ohmydigifab/OpenBLW/README.md

# OpenBLW
Open Biwa Lake Walker

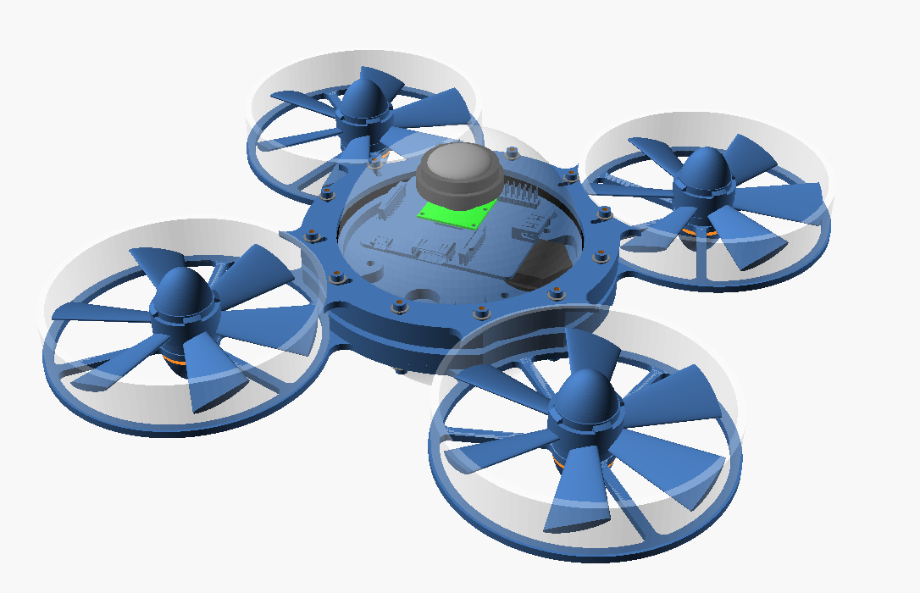
[picture p1: resources/OpenBLW.png]
OpenBLW
