ohmydigifab/OpenBLW/pcb/interface_board/interface_board-BOM.xls

Qty | Value | Part No. | Device | Package | Parts | Description | CATEGORY | CURRENT-MAX | CURRENT-TRIP | DESCRIPTION | DOCUMENTATION_LINK | DOCUMENTATION_URL | FAMILY | MANUFACTURER | MPN | OC_FARNELL | OC_NEWARK | PACKAGE | PART_NUMBER | R_MINMAX | SERIES | SUPPLIER | SUPPLIER_ITEM_LINK | SUPPLIER_ITEM_NUMBER | SUPPLIER_ITEM_URL | SUPPLIER_LINK | SUPPLIER_NAME | SUPPLIER_URL | TIME_TO_TRIP | VOLTAGE-MAX
2 | 0R | ERJ-2GE0R00X | R-EU_R0402 | R0402 | R2, R3 | RESISTOR, European symbol
3 | 0R | ERJ-6GEY0R00V | R-EU_R0805 | R0805 | R7, R8, R9 | RESISTOR, European symbol
4 | 1.8K | ERJ-2GEJ182X | R-EU_R0402 | R0402 | R13, R14, R16, R17 | RESISTOR, European symbol
1 | 10R | ERJ-3EKF10R0V | R-EU_R0603 | R0603 | R27 | RESISTOR, European symbol
3 | 100K | ERJ-2GEJ104X | R-EU_R0402 | R0402 | R1, R11, R12 | RESISTOR, European symbol
1 | 100n | EMK105B7104KV-F | C-EUC0402 | C0402 | C1 | CAPACITOR, European symbol
18 | 100n | EMK107B7104KA-T | C-EUC0603 | C0603 | C8, C9, C26, C27, C28, C29, C30, C31, C32, C33, C34, C35, C36, C37, C38, C39, C40, C43 | CAPACITOR, European symbol
1 | 10n | EMK105B7103KV-F | C-EUC0402 | C0402 | C17 | CAPACITOR, European symbol
6 | 10u | EMK212BJ106KG-T | C-EUC0805 | C0805 | C2, C3, C6, C7, C10, C41 | CAPACITOR, European symbol
1 | 10u | UUD1E100MCL1GS | CPOL-EU153CLV-0405 | 153CLV-0405 | C15 | POLARIZED CAPACITOR, European symbol
4 | 12k | ERJ-3GEYJ123V | R-EU_R0603 | R0603 | R10, R20, R32, R37 | RESISTOR, European symbol
1 | 12k4 | ERJ-3EKF1242V | R-EU_R0603 | R0603 | R33 | RESISTOR, European symbol
1 | 1473005-4 | 1473005-4 | RPI_COMPUTE | RPI_COMPUTE | PCB1 | Device for a Raspberry PI Compute module.
1 | 1K | ERJ-2GEJ102X | R-EU_R0402 | R0402 | R18 | RESISTOR, European symbol
2 | 1k | ERJ-3GEYJ102V | R-EU_R0603 | R0603 | R25, R26 | RESISTOR, European symbol
1 | 1u | EMK105BJ105KV-F | C-EUC0402 | C0402 | C16 | CAPACITOR, European symbol
1 | 1u | EMK212B7105KG-T | C-EUC0805 | C0805 | C42 | CAPACITOR, European symbol
4 | 20p | GRM1885C1H200JA01D | C-EUC0603 | C0603 | C21, C22, C23, C24 | CAPACITOR, European symbol
1 | 22u | UUD1A220MCL1GS | CPOL-EU153CLV-0405 | 153CLV-0405 | C11 | POLARIZED CAPACITOR, European symbol
2 | 282836-2 | 282836-2 | 282836-2 | 282836-2 | U$1, U$2 | TYCO 282836-2 TERM BLOCK 2POS SIDE ENTRY 5MM EURISTYLE
2 | 4.7u | SRN4018-4R7M | BOURNS-SRN4018 | BOURNS-SRN4018 | L1, L2
2 | 470R | ERJ-2GEJ471X | R-EU_R0402 | R0402 | R6, R15 | RESISTOR, European symbol
3 | 47u | GRM31CR60J476ME19L | C-EUC1206 | C1206 | C12, C13, C14 | CAPACITOR, European symbol
4 | 49.9 | ERJ-3EKF49R9V | R-EU_R0603 | R0603 | R28, R29, R30, R31 | RESISTOR, European symbol
1 | 61400416021 | 61400416021 | 61400416021 | 61400416021 | K1 | WR-COM Horizontal USB Type A
1 | DMG1012T | DMG1012T-7 | DMG1012T | SOT523 | U3 | Generic NMOS FET
2 | FERRITE_BEAD | 742792022 | FERRITE_BEAD | C0805 | FB2, FB3
1 | GREEN | LTST-C193KGKT-5A | LEDCHIP-LED0603 | CHIP-LED0603 | LED2 | LED
1 | HR911105A | HR911105A | HR911105A | RJ45 | ETHERNET | Low cost RJ45 connector with integrated magnetics and LEDs. www.hasseb.fi
1 | LAN9512 | LAN9512-JZX | LAN9512 | QFN64-9X9 | IC6
2 | M20-9980346 | M20-9980346 | TENDA_P200 | TENDA_P200 | JP2, JP3
1 | M20-9980446 | M20-9980446 | PINHD-2X4 | 2X04 | JP1 | PIN HEADER
1 | M20-9990246 | M20-9990246 | PINHD-1X1 | 1X01 | JP4 | PIN HEADER
1 | MF-MSMF200 | MF-MSMF200-2 | MF-MSMF075/24 | 1812 | F1 | PTC Resettable Fuse | Circuit Protection | 40A | 1.5A | PTC RESETTABLE .75A 24V 1812 | <a href=http://www.bourns.com/data/global/pdfs/mfmsmf.pdf">Datasheet</a>" | http://www.bourns.com/data/global/pdfs/mfmsmf.pdf | PTC Resettable Fuses | Bourns Inc. |  |  |  | 1812 (4532 Metric), Concave | MF-MSMF075/24-2 | 0.11 ~ 0.450 Ohm | MF-MSMF |  | <a href=http://www.digikey.com/product-detail/en/MF-MSMF075%2F24-2/MF-MSMF075%2F24-2CT-ND/662844">Details</a>" | MF-MSMF075/24-2CT-ND | http://www.digikey.com/product-detail/en/MF-MSMF075%2F24-2/MF-MSMF075%2F24-2CT-ND/662844 | <a href=http://www.digikey.com">Home Page</a>" | Digi-Key | http://www.digikey.com | 0.2s | 24V
2 | HR2220V801R-10 | HR2220V801R-10 | L-EUL5650M | L5650M | FB1, FB4 | INDUCTOR, European symbol
4 | MOUNT-PAD-ROUND2.8 |  | MOUNT-PAD-ROUND2.8 | 2,8-PAD | H1, H2, H3, H4 | MOUNTING PAD, round
2 | NF |  | C-EUC0402 | C0402 | C4, C5 | CAPACITOR, European symbol
2 | NR |  | R-EU_R0402 | R0402 | R4, R5 | RESISTOR, European symbol
1 | PAM2306AYPKE | PAM2306AYPKE | PAM2306 | WDFN3X3-12L | U5
1 | RED | LTST-C193KRKT-5A | LEDCHIP-LED0603 | CHIP-LED0603 | LED1 | LED
2 | SFW15R-1STE1LF | SFW15R-1STE1LF | RPI_CAMERA | RPI_CAMERA | U1, U2 | FFC/FPC CONNECTOR, RECEPTACLE 16POS 1ROW |  |  |  |  |  |  |  |  | SFW16R-1STE1LF | 1835594 | 62K5606 | CONNECTOR- 16POS |  |  |  | FCI
1 | SRP1250A | SRP1245A-100M | SRP1250A | SRP1250A | L3 | POWER INDUCTOR
1 | V7805-1000 | V7805-1000 | VR_1OUTXX | DIP_3PIN | IC1 | VOLTAGE REGULATOR
