ohmydigifab/OpenBLW/pcb/driver_board/digi-key-BOM.xls

Digi-Key品番 | 仕入先 | メーカー品番 | 客先参照品番（任意） | 数量 1 | 数量 2 | 数量 3 | 製造標準リードタイム | 商品概要 | 注記事項 | RoHS ステータス | 鉛フリーステータス | REACHステータス
P100KJCT-ND | PANASONIC ELECTRONIC COMPONENTS (VA) | ERJ-2GEJ104X |  | 1 | 0 | 0 | 6 週間 | RES SMD 100K OHM 5% 1/10W 0402 | 他の梱包形態が存在します。 | RoHS対応 | 鉛フリー | 影響なし 12-2014
709-1129-1-ND | JOHANSON DIELECTRICS INC (VA) | 160R07X104KV4T |  | 1 | 0 | 0 | 7 週間 | CAP CER 0.1UF 16V X5R 0402 | 他の梱包形態が存在します。 | RoHS対応 | 鉛フリー | 影響なし 6-2015
P1.0KJCT-ND | PANASONIC ELECTRONIC COMPONENTS (VA) | ERJ-2GEJ102X |  | 1 | 0 | 0 | 6 週間 | RES SMD 1K OHM 5% 1/10W 0402 | 他の梱包形態が存在します。 | RoHS対応 | 鉛フリー | 影響なし 12-2014
493-2192-1-ND | NICHICON (VA) | UWT1E221MNL1GS |  | 2 | 0 | 0 | 15 週間 | CAP ALUM 220UF 20% 25V SMD | 他の梱包形態が存在します。 | RoHS対応 | 鉛フリー | 影響なし 6-2014
A98076-ND | TE CONNECTIVITY AMP | 282836-2 |  | 1 | 0 | 0 | 2 週間 | TERM BLOCK 2POS SIDE ENTRY 5MM |  | RoHS対応 | 鉛フリー | Not Available
P4.99KLCT-ND | PANASONIC ELECTRONIC COMPONENTS (VA) | ERJ-2RKF4991X |  | 1 | 0 | 0 | 6 週間 | RES SMD 4.99K OHM 1% 1/10W 0402 | 他の梱包形態が存在します。 | RoHS対応 | 鉛フリー | 影響なし 12-2014
AL5812MP-13DICT-ND | DIODES INCORPORATED (VA) | AL5812MP-13 |  | 1 | 0 | 0 | 8 週間 | IC LED DRVR LIN DIM 150MA 8MSOP | 他の梱包形態が存在します。 | RoHS対応 | 鉛フリー | 影響なし 12-2015
160-2095-1-ND | LITE-ON INC (VA) | LTW-5630AZL50 |  | 2 | 0 | 0 | 12 週間 | LED AZL COOL WHITE 5000K 4SMD | 他の梱包形態が存在します。 | RoHS対応 | 鉛フリー | Not Available
952-2266-ND | HARWIN INC | M20-9990446 |  | 1 | 0 | 0 | 6 週間 | SIL VERTICAL PC TAIL PIN HEADER |  | RoHS対応 | 鉛フリー | 影響なし 12-2015
IRLML6346TRPBFCT-ND | INFINEON TECHNOLOGIES AMERICAS CORP. (VA) | IRLML6346TRPBF |  | 1 | 0 | 0 | 14 週間 | MOSFET N-CH 30V 3.4A SOT23 | 他の梱包形態が存在します。 | RoHS対応 | 鉛フリー | 影響なし 12-2015
