ohmydigifab/OpenBLW/pcb/interface_board/gerber/pban/parts_list.xls

Sheet: 必ずお読みください
入力項目説明
メ ー カ ー |  |  | 電子部品のメーカー名をご入力ください。
部 品 種 別 |  |  | 電子部品の種別をご入力ください。例：チップ抵抗、トランジスタ、LED、など
電 子 部 品 型 番 |  |  | 電子部品の型番をご入力ください。 ※誤表記による不具合を回避するためにも正確なご入力をお願い致します。 ※表面実装の抵抗やコンデンサ(電解、タンタル以外)は、後述「電子部品見取り表」をご参照のうえ、ご入力ください。
配 置 記 号 / リファレンス |  |  | シルク図/配置図に表記された配置記号/リファレンス番号をご入力ください。 ※複数入力する場合は、カンマ「,」区切りでのご入力をお願い致します。 ※電子部品型番ベースでのご記入をお願い致します。（１つの電子部品型番に対して、配置番号を複数記入）
個 数 |  |  | 電子部品の個数をご入力ください。
ピ ン 数 |  |  | 電子部品の総ピン数をご入力ください。 ※基板取付穴、部品取付穴、全てのスルー・ノンスルーホール、面実装部品のパッド、及び次の①～⑤の配線を伴う箇所（①テストピン、②チェックランド、③引き出しランド、④ジャンパピン、⑤入出力ランドの総計。
実装 / 未実装 |  |  | 実装サービスでの「実装」/「未実装」をご選択ください。 ※同じ電子部品型番の中で実装と未実装が分かれる場合は、それぞれ2行に分けて配置記号をご入力ください。
部品分類 | SMD |  | 表面実装部品
 | DIP |  | 挿入部品
 | 特殊 BGA等 |  | BGA/CSP/LGA/QFNなど部品極性が部品の真下に配置された部品 -BGA：Ball Grid Array/下面に半田ボールの端子を配置したパッケージ。 -CSP：Chip Size Package/チッププサイズと同じか、もしくは僅かに大きいパッケージ。 -LGA：Land Grid Array/裏面に外部入出力用のランドを設けたパッケージ。※BGAの半田ボールがない。 -QFN：Quad Flat Non-Lead Package/QFPに似ていますが、外部入出力用のピンが出ていないパッケージ。
P板.com提供部品 (無料) |  |  | P板.com実装サービスで無料提供しているチップ部品が含まれている場合に○をご選択ください。 ※無料提供部品：チップコンデンサ/チップ抵抗を約1500種、実装サービスをご利用のお客様に無料提供いたします。
 |  |  | http://www.p-ban.com/implementation/chip.html
P板.com調達部品(有料） |  |  | P板.com実装サービスで部品調達を希望される場合に○をご選択ください。 ※調達費用のお見積もりは、部品リストの返却と同時にご連絡いたします。 ※ご希望の納期や市場在庫状況によっては、調達が不可となる部品もございますので、予めご了承ください。
パッケージ情報 部品外形/部品仕様 |  |  | 電子部品のパッケージ情報をご入力ください。例：1608 , DIP , 0.5mmピッチQFP , 0.4mmピッチCN
コ メ ン ト |  |  | 特別なご指示のある電子部品について、自由にご入力ください。 例：未実装挿入穴のマスク処理が必要、など
版、変更履歴 |  |  | 部品種毎に、変更履歴を記載してください。 版は、アカウント登録の版に合わせて記載ください。
調達型式、代替型式 |  |  | 無料提供部品の在庫切れや、正確な調達型式を記載いたします。
部品名称見取り表
1.チップ部品（抵抗、コンデンサ）
 |  |  |  |  | 単位：ｍｍ
 |  |  | 電子部品型番 (C:コンデンサ、R:抵抗） | Ａ寸法 | Ｂ寸法
 |  |  | C/R1608 | 1.6 | 0.8
 |  |  | C/R2125 | 2 | 1.25
 |  |  | C/R3216 | 3.2 | 1.6
 |  |  | C/R3225 | 3.2 | 2.5
 |  |  | C/R4532 | 4.5 | 3.2
2.チップタンタルコンデンサ
 |  |  |  |  | 単位：ｍｍ
 |  |  | 電子部品型番 | Ａ寸法 | Ｂ寸法
 |  |  | CT3216 | 3.2 | 1.6
 |  |  | CT3528 | 3.5 | 2.8
 |  |  | CT4726 | 4.7 | 2.6
 |  |  | CT6032 | 6 | 3.2
 |  |  | CT5846 | 5.8 | 4.6
 |  |  | CT7343 | 7.3 | 4.3
3.チップアルミ電解コンデンサ
 |  |  |  |  |  | 単位：ｍｍ
 |  |  | 電子部品型番 | Ａ寸法 | Ｂ寸法 | C寸法
 |  |  | CE33 | 3.3 | 3.3 | φ3.0
 |  |  | CE43 | 4.3 | 4.3 | φ4.0
 |  |  | CE53 | 5.3 | 5.3 | φ5.0
 |  |  | CE66 | 6.6 | 6.6 | φ6.3
 |  |  | CE83 | 8.3 | 8.3 | φ8.0
 |  |  | CE103 | 10.3 | 10.3 | φ10.0
部品取り付け穴は、ピン数に含めてください。
コネクタの場合 |  |  |  |  |  | トランスの場合
部品リストフォーマット変更履歴
2014-02-01 | v2.0 | 松森 | 部品種別の総計を、直接関数に変更
 |  |  | ピン数合計、実装数合計数量を、直接関数に変更
 |  |  | 部品調達見積欄を修正
2014-03-11 | v2.1 | 松森 | *N列、O列が下の方、"○"選択リスト消えていたのを追加
 |  |  | *縮小しても解像度崩れず文字表示するため、フォントを"Meiryo UI"(Windows 標準添付)に変更
 |  |  | *136行目以降を非表示
 |  |  | *"X"列にリストを埋め込み
2014-06-12 | v2.2 | 松森 | *固定行を変更
 |  |  | *在庫状況列に条件付き書式設定
 |  |  | *その他各種バグ修正
2015-03-31 | V2.3 | 松森 | *無償提供部品を記載すると、無償提供部品欄に自動で"○"が表示されるよう条件式を挿入
 |  |  | *併せて、無償提供部品参照用一覧シートの作成・追加
 |  |  | *最小購入数が必要数量を下回る場合、セルを赤色にハッチングする
 |  |  | *シート1の名称変更
 |  |  | *変更履歴シートの追加
2015-06-19 | v2.4 | 松森 | ・ゼロΩ抵抗を無償対象に追加
 |  |  | ・変更履歴の列を追加し、変更履歴シートを削除
 |  |  | ・その他書式、印刷機能の変更
 |  |  | ・無償提供部品の入れ替え
2015-08-14 | v2.5 | 松森 | ・ゼロΩ抵抗の無償対象品が正しく反映されていなかったバグ修正
 |  |  | ・フォームへバージョン情報を埋め込み
2015-11-05 | v2.6 | 上田 | ・無償提供部品(RK73H2ATTD1601F)の抵抗値を正しい値に修正
2015-11-09 | v2.7 | 上田 | ・P板.com調達部品(無料)欄のフォントを変更
2016-01-15 | v2.8 | 箕浦 | ・無償提供部品一覧の「GRM32NF11E106Z」を削除
 |  |  | ・部品リスト入力フォームの4行目F列～L列の計算式が136行目以降を対象としていなかった不具合を修正
2016-01-27 | v2.9 | 箕浦 | ・「無償提供部品一覧」シートの表記修正

Sheet: 部品リスト入力フォーム
Ver.2.9 |  |  | 電 子 部 品 型 番 ※半角英数字 ※サフィックスまで入力必須 | 配 置 記 号 リ フ ァ レ ン ス ※半角英数字） | 個数 | ピ ン 数 (部品取付穴 を含む） |  | 実装/ 未実装 | 部 品 分 類 |  |  | 必要数 実装枚数を入れてください。 ↓ | P板.com 提供 部品 (無料) | P板.com 調達 部品 (有料） | パッケージ情報 部品外形/部品仕様 | コ メ ン ト ※未実装挿入穴のマスク処理が必要、など | 版 変更履歴 | 調達型式、代替型式 |  | 入荷数 | 返却
No | メーカー | 部品種別 |  |  |  | 1個 あたり | 合計 | 実装個数 | SMD | DIP | 特殊 BGA等 |  |  |  |  |  |  | メーカー | 型名 |  |  | 部品調達使用欄
 |  |  |  |  | 52 | 302 | 353 | 43 | 39 | 4 | 0 | 3 | リスト (http://www.p-ban.com/implementation/chip.html)
例 | KOA | チップ抵抗 | RK73B2ATTD1002F | R1,R5,R9,R10 | 4 | 2 | 8 | 未実装 | SMD |  |  |  |  |  | 2012 |  | 4版 型式訂正、個数変更、実装→未実装へ |  |  |  |  | 必要数 | 調達数 | 在庫状況 | 納期
1 □ | KOA | チップ抵抗 | RK73Z1ETTP | R2, R3 | 2 | 2 | 4 | 実装 | SMD |  |  | 6 | ○ |  | R1005 | 0R |  |  |  |  | □
2 □ | generic | チップ抵抗 | RK73Z2ATTD | R7, R8, R9, R10 | 4 | 2 | 8 | 実装 | SMD |  |  | 12 | ○ |  | R2010 | 0R |  |  |  |  | □
3 □ | generic | チップ抵抗 | RK73B1ETTP182J | R13, R14, R16, R17 | 4 | 2 | 8 | 実装 | SMD |  |  | 12 | ○ |  | R1005 | 1.8K |  |  |  |  | □
4 □ | generic | チップ抵抗 | RK73H1ETTP1003F | R1, R11, R12 | 3 | 2 | 6 | 実装 | SMD |  |  | 9 | ○ |  | R1005 | 100K |  |  |  |  | □
5 □ | generic | コンデンサ | GRM155B11A104K | C1, C9 | 2 | 2 | 4 | 実装 | SMD |  |  | 6 | ○ |  | C1005 | 100n |  |  |  |  | □
6 □ | generic | コンデンサ | GRM21BB31A106K | C2, C3, C6, C7 | 4 | 2 | 8 | 実装 | SMD |  |  | 12 | ○ |  | C2010 | 10u |  |  |  |  | □
7 □ | generic | コンデンサ | 10u | C15 | 1 | 2 | 2 | 実装 | SMD |  |  | 3 |  | ○ | 153CLV-0405 | 10u |  |  |  |  | □ | 3
8 □ | TE | ソケット | 1473005-4 | PCB1 | 1 | 202 | 202 | 実装 | SMD |  |  | 3 |  | ○ | DDR2SODIMM | 1473005-4 |  |  |  |  | □ | 3
9 □ | generic | コンデンサ | GRM155B30J105K | C8 | 1 | 2 | 2 | 実装 | SMD |  |  | 3 | ○ |  | C1005 | 1u |  |  |  |  | □
10 □ | generic | コンデンサ | 22u | C11 | 1 | 2 | 2 | 実装 | SMD |  |  | 3 |  | ○ | 153CLV-0405 | 22u |  |  |  |  | □ | 3
11 □ | BOURNS | インダクタ | 4.7u | L1, L2 | 2 | 2 | 4 | 実装 | SMD |  |  | 6 |  | ○ | BOURNS-SRN4018 | 4.7u |  |  |  |  | □ | 6
12 □ | generic | コンデンサ | GRM188B10J225K | C10 | 1 | 2 | 2 | 実装 | SMD |  |  | 3 | ○ |  | C1608 | 4.7u |  |  |  |  | □
13 □ | generic | チップ抵抗 | RK73H1ETTP4700F | R6, R15 | 2 | 2 | 4 | 実装 | SMD |  |  | 6 | ○ |  | R1005 | 470R |  |  |  |  | □
14 □ | generic | コンデンサ | GRM21BB30J226M | C12, C13, C14 | 3 | 2 | 6 | 実装 | SMD |  |  | 9 | ○ |  | C1206 | 47u |  |  |  |  | □
15 □ | Wurth | USBコネクタ | 61400416021 | K1 | 1 | 6 | 6 | 実装 | DIP |  |  | 3 |  | ○ | 61400416021 | 61400416021 |  |  |  |  | □ | 3
16 □ | Molex | 基板ヘッダ | 90131-0764 | JP1 | 1 | 8 | 8 | 実装 | DIP |  |  | 3 |  | ○ | 2X04 | 90131-0764 |  |  |  |  | □ | 3
17 □ | Diodes Incorporated | レギュレータ | AP7115-25SEG | U6 | 1 | 5 | 5 | 実装 | SMD |  |  | 3 |  | ○ | SOT353 | AP7115-25SEG |  |  |  |  | □ | 3
18 □ | JST | PCBコネクタ | B2B-PH-K-S | CN1 | 1 | 2 | 2 | 実装 | DIP |  |  | 3 |  | ○ | JST-PH-2-THM | B2B-PH-K-S |  |  |  |  | □ | 3
19 □ | Diodes Incorporated | NFET | DMG1012T | U3 | 1 | 3 | 3 | 実装 | SMD |  |  | 3 |  | ○ | SOT523 | DMG1012T |  |  |  |  | □ | 3
20 □ | generic | LED | GREEN | LED2 | 1 | 2 | 2 | 実装 | SMD |  |  | 3 |  | ○ | CHIP-LED1608 | GREEN |  |  |  |  | □ | 3
21 □ | BOURNS | リセッタブルヒューズ | MF-MSMF200 | F1 | 1 | 2 | 2 | 実装 | SMD |  |  | 3 |  | ○ | 1812 | MF-MSMF200 |  |  |  |  | □ | 3
22 □ | - | 基板取り付け穴 | MOUNT-PAD-ROUND2.8 | H1, H2, H3, H4 | 4 |  | 0 | 未実装 |  |  |  | 0 |  |  | 2,8-PAD | MOUNT-PAD-ROUND2.8 |  |  |  |  | □
23 □ | - | - | NF | C4, C5 | 2 |  | 0 | 未実装 |  |  |  | 0 |  |  | C1005 | NF |  |  |  |  | □
24 □ | - | - | NR | R4, R5 | 2 |  | 0 | 未実装 |  |  |  | 0 |  |  | R1005 | NR |  |  |  |  | □
25 □ | Diodes Incorporated | DCDCコンバータ | PAM2306AYPKE | U5 | 1 | 12 | 12 | 実装 | SMD |  |  | 3 |  | ○ | WDFN3X3-12L | PAM2306AYPKE |  |  |  |  | □ | 3
26 □ | generic | LED | RED | LED1 | 1 | 2 | 2 | 実装 | SMD |  |  | 3 |  | ○ | CHIP-LED1608 | RED |  |  |  |  | □ | 3
27 □ | FCI | FPCコネクタ | SFW15R-1STE1LF | U1, U2 | 2 | 17 | 34 | 実装 | SMD |  |  | 6 |  | ○ | FPC1mm pitch 15pin | SFW15R-1STE1LF |  |  |  |  | □ | 6
28 □ | TENDA | PLCモジュール | TENDA_P200 | U4 | 1 | 12 | 12 | 未実装 | DIP |  |  | 0 |  |  | TENDA_P200 | TENDA_P200 |  |  |  |  | □
29 □ | CUI Inc | DCDCコンバータ | V7805-1000 | IC1 | 1 | 3 | 3 | 実装 | DIP |  |  | 3 |  | ○ | DIP_3PIN | V7805-1000 |  |  |  |  | □ | 3
30 □ |  |  |  |  |  |  |  |  |  |  |  |  |  |  |  |  |  |  |  |  | □
31 □ |  |  |  |  |  |  |  |  |  |  |  |  |  |  |  |  |  |  |  |  | □
32 □ |  |  |  |  |  |  |  |  |  |  |  |  |  |  |  |  |  |  |  |  | □
33 □ |  |  |  |  |  |  |  |  |  |  |  |  |  |  |  |  |  |  |  |  | □
34 □ |  |  |  |  |  |  |  |  |  |  |  |  |  |  |  |  |  |  |  |  | □
35 □ |  |  |  |  |  |  |  |  |  |  |  |  |  |  |  |  |  |  |  |  | □
36 □ |  |  |  |  |  |  |  |  |  |  |  |  |  |  |  |  |  |  |  |  | □
37 □ |  |  |  |  |  |  |  |  |  |  |  |  |  |  |  |  |  |  |  |  | □
38 □ |  |  |  |  |  |  |  |  |  |  |  |  |  |  |  |  |  |  |  |  | □
39 □ |  |  |  |  |  |  |  |  |  |  |  |  |  |  |  |  |  |  |  |  | □
40 □ |  |  |  |  |  |  |  |  |  |  |  |  |  |  |  |  |  |  |  |  | □
41 □ |  |  |  |  |  |  |  |  |  |  |  |  |  |  |  |  |  |  |  |  | □
42 □ |  |  |  |  |  |  |  |  |  |  |  |  |  |  |  |  |  |  |  |  | □
43 □ |  |  |  |  |  |  |  |  |  |  |  |  |  |  |  |  |  |  |  |  | □
44 □ |  |  |  |  |  |  |  |  |  |  |  |  |  |  |  |  |  |  |  |  | □
45 □ |  |  |  |  |  |  |  |  |  |  |  |  |  |  |  |  |  |  |  |  | □
46 □ |  |  |  |  |  |  |  |  |  |  |  |  |  |  |  |  |  |  |  |  | □
47 □ |  |  |  |  |  |  |  |  |  |  |  |  |  |  |  |  |  |  |  |  | □
48 □ |  |  |  |  |  |  |  |  |  |  |  |  |  |  |  |  |  |  |  |  | □
49 □ |  |  |  |  |  |  |  |  |  |  |  |  |  |  |  |  |  |  |  |  | □
50 □ |  |  |  |  |  |  |  |  |  |  |  |  |  |  |  |  |  |  |  |  | □
51 □ |  |  |  |  |  |  |  |  |  |  |  |  |  |  |  |  |  |  |  |  | □
52 □ |  |  |  |  |  |  |  |  |  |  |  |  |  |  |  |  |  |  |  |  | □
53 □ |  |  |  |  |  |  |  |  |  |  |  |  |  |  |  |  |  |  |  |  | □
54 □ |  |  |  |  |  |  |  |  |  |  |  |  |  |  |  |  |  |  |  |  | □
55 □ |  |  |  |  |  |  |  |  |  |  |  |  |  |  |  |  |  |  |  |  | □
56 □ |  |  |  |  |  |  |  |  |  |  |  |  |  |  |  |  |  |  |  |  | □
57 □ |  |  |  |  |  |  |  |  |  |  |  |  |  |  |  |  |  |  |  |  | □
58 □ |  |  |  |  |  |  |  |  |  |  |  |  |  |  |  |  |  |  |  |  | □
59 □ |  |  |  |  |  |  |  |  |  |  |  |  |  |  |  |  |  |  |  |  | □
60 □ |  |  |  |  |  |  |  |  |  |  |  |  |  |  |  |  |  |  |  |  | □
61 □ |  |  |  |  |  |  |  |  |  |  |  |  |  |  |  |  |  |  |  |  | □
62 □ |  |  |  |  |  |  |  |  |  |  |  |  |  |  |  |  |  |  |  |  | □
63 □ |  |  |  |  |  |  |  |  |  |  |  |  |  |  |  |  |  |  |  |  | □
64 □ |  |  |  |  |  |  |  |  |  |  |  |  |  |  |  |  |  |  |  |  | □
65 □ |  |  |  |  |  |  |  |  |  |  |  |  |  |  |  |  |  |  |  |  | □
66 □ |  |  |  |  |  |  |  |  |  |  |  |  |  |  |  |  |  |  |  |  | □
67 □ |  |  |  |  |  |  |  |  |  |  |  |  |  |  |  |  |  |  |  |  | □
68 □ |  |  |  |  |  |  |  |  |  |  |  |  |  |  |  |  |  |  |  |  | □
69 □ |  |  |  |  |  |  |  |  |  |  |  |  |  |  |  |  |  |  |  |  | □
70 □ |  |  |  |  |  |  |  |  |  |  |  |  |  |  |  |  |  |  |  |  | □
71 □ |  |  |  |  |  |  |  |  |  |  |  |  |  |  |  |  |  |  |  |  | □
72 □ |  |  |  |  |  |  |  |  |  |  |  |  |  |  |  |  |  |  |  |  | □
73 □ |  |  |  |  |  |  |  |  |  |  |  |  |  |  |  |  |  |  |  |  | □
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
134 □ |  |  |  |  |  |  |  |  |  |  |  |  |  |  |  |  |  |  |  |  | □
135 □ |  |  |  |  |  |  |  |  |  |  |  |  |  |  |  |  |  |  |  |  | □
136 □ |  |  |  |  |  |  |  |  |  |  |  |  |  |  |  |  |  |  |  |  | □
137 □ |  |  |  |  |  |  |  |  |  |  |  |  |  |  |  |  |  |  |  |  | □
138 □ |  |  |  |  |  |  |  |  |  |  |  |  |  |  |  |  |  |  |  |  | □
139 □ |  |  |  |  |  |  |  |  |  |  |  |  |  |  |  |  |  |  |  |  | □
140 □ |  |  |  |  |  |  |  |  |  |  |  |  |  |  |  |  |  |  |  |  | □
141 □ |  |  |  |  |  |  |  |  |  |  |  |  |  |  |  |  |  |  |  |  | □
142 □ |  |  |  |  |  |  |  |  |  |  |  |  |  |  |  |  |  |  |  |  | □
143 □ |  |  |  |  |  |  |  |  |  |  |  |  |  |  |  |  |  |  |  |  | □
144 □ |  |  |  |  |  |  |  |  |  |  |  |  |  |  |  |  |  |  |  |  | □
145 □ |  |  |  |  |  |  |  |  |  |  |  |  |  |  |  |  |  |  |  |  | □
146 □ |  |  |  |  |  |  |  |  |  |  |  |  |  |  |  |  |  |  |  |  | □
147 □ |  |  |  |  |  |  |  |  |  |  |  |  |  |  |  |  |  |  |  |  | □
148 □ |  |  |  |  |  |  |  |  |  |  |  |  |  |  |  |  |  |  |  |  | □

Sheet: 無償提供部品一覧
このシートの内容は変更しないでください。
メーカー型番 |  | メーカー | サイズ | 定数 | 許容差 | 定格
RK73Z1ETTP | ○ | KOA | 1005 | 0 |  | 1A
RK73H1ETTP1R00F | ○ | KOA | 1005 | 1 | ±1% | 0.063W
RK73B1ETTP1R0J | ○ | KOA | 1005 | 1 | ±5% | 0.063W
RK73H1ETTP1R10F | ○ | KOA | 1005 | 1.1 | ±1% | 0.063W
RK73B1ETTP1R1J | ○ | KOA | 1005 | 1.1 | ±5% | 0.063W
RK73H1ETTP1R20F | ○ | KOA | 1005 | 1.2 | ±1% | 0.063W
RK73B1ETTP1R2J | ○ | KOA | 1005 | 1.2 | ±5% | 0.063W
RK73H1ETTP1R30F | ○ | KOA | 1005 | 1.3 | ±1% | 0.063W
RK73B1ETTP1R3J | ○ | KOA | 1005 | 1.3 | ±5% | 0.063W
RK73H1ETTP1R50F | ○ | KOA | 1005 | 1.5 | ±1% | 0.063W
RK73B1ETTP1R5J | ○ | KOA | 1005 | 1.5 | ±5% | 0.063W
RK73H1ETTP1R60F | ○ | KOA | 1005 | 1.6 | ±1% | 0.063W
RK73B1ETTP1R6J | ○ | KOA | 1005 | 1.6 | ±5% | 0.063W
RK73H1ETTP1R80F | ○ | KOA | 1005 | 1.8 | ±1% | 0.063W
RK73B1ETTP1R8J | ○ | KOA | 1005 | 1.8 | ±5% | 0.063W
RK73H1ETTP2R00F | ○ | KOA | 1005 | 2 | ±1% | 0.063W
RK73B1ETTP2R0J | ○ | KOA | 1005 | 2 | ±5% | 0.063W
RK73H1ETTP2R20F | ○ | KOA | 1005 | 2.2 | ±1% | 0.063W
RK73B1ETTP2R2J | ○ | KOA | 1005 | 2.2 | ±5% | 0.063W
RK73H1ETTP2R40F | ○ | KOA | 1005 | 2.4 | ±1% | 0.063W
RK73B1ETTP2R4J | ○ | KOA | 1005 | 2.4 | ±5% | 0.063W
RK73H1ETTP2R70F | ○ | KOA | 1005 | 2.7 | ±1% | 0.063W
RK73B1ETTP2R7J | ○ | KOA | 1005 | 2.7 | ±5% | 0.063W
RK73H1ETTP3R00F | ○ | KOA | 1005 | 3 | ±1% | 0.063W
RK73B1ETTP3R0J | ○ | KOA | 1005 | 3 | ±5% | 0.063W
RK73H1ETTP3R30F | ○ | KOA | 1005 | 3.3 | ±1% | 0.063W
RK73B1ETTP3R3J | ○ | KOA | 1005 | 3.3 | ±5% | 0.063W
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
GRM155B11H681K | ○ | MURATA | 1005 | 680pF | ±10% | DC50V
GRM1552C1H821J | ○ | MURATA | 1005 | 820pF | ±5% | DC50V
GRM155B11H821K | ○ | MURATA | 1005 | 820pF | ±10% | DC50V
GRM1552C1H102J | ○ | MURATA | 1005 | 1000pF | ±5% | DC50V
GRM155B11H102K | ○ | MURATA | 1005 | 1000pF | ±10% | DC50V
GRM155B11H122K | ○ | MURATA | 1005 | 1200pF | ±10% | DC50V
GRM155B11H152K | ○ | MURATA | 1005 | 1500pF | ±10% | DC50V
GRM155B11H182K | ○ | MURATA | 1005 | 1800pF | ±10% | DC50V
GRM155B11H222K | ○ | MURATA | 1005 | 2200pF | ±10% | DC50V
GRM155B11H272K | ○ | MURATA | 1005 | 2700pF | ±10% | DC50V
GRM155B11H332K | ○ | MURATA | 1005 | 3300pF | ±10% | DC50V
GRM155B11H392K | ○ | MURATA | 1005 | 3900pF | ±10% | DC50V
GRM155B11H472K | ○ | MURATA | 1005 | 4700pF | ±10% | DC50V
GRM155B11E682K | ○ | MURATA | 1005 | 6800pF | ±10% | DC25V
GRM155B11E822K | ○ | MURATA | 1005 | 8200pF | ±10% | DC25V
GRM155B11E103K | ○ | MURATA | 1005 | 0.01uF | ±10% | DC25V
GRM155F11H103Z | ○ | MURATA | 1005 | 0.01uF | ＋80%, －20% | DC50V
GRM155B11C153K | ○ | MURATA | 1005 | 0.015uF | ±10% | DC16V
GRM155F11H153Z | ○ | MURATA | 1005 | 0.015uF | ＋80%, －20% | DC50V
GRM155B11C183K | ○ | MURATA | 1005 | 0.018uF | ±10% | DC16V
GRM155F11E223Z | ○ | MURATA | 1005 | 0.022uF | ＋80%, －20% | DC25V
GRM155B11C223K | ○ | MURATA | 1005 | 0.022uF | ±10% | DC16V
GRM155B11A333K | ○ | MURATA | 1005 | 0.033uF | ±10% | DC10V
GRM155F11E333Z | ○ | MURATA | 1005 | 0.033uF | ＋80%, －20% | DC25V
GRM155B11A473K | ○ | MURATA | 1005 | 0.047uF | ±10% | DC10V
GRM155F11C473Z | ○ | MURATA | 1005 | 0.047uF | ＋80%, －20% | DC16V
GRM155B11A563K | ○ | MURATA | 1005 | 0.056uF | ±10% | DC10V
GRM155B11A683K | ○ | MURATA | 1005 | 0.068uF | ±10% | DC10V
GRM155B11A823K | ○ | MURATA | 1005 | 0.082uF | ±10% | DC10V
GRM155B11A104K | ○ | MURATA | 1005 | 0.1uF | ±10% | DC10V
GRM155F11C104Z | ○ | MURATA | 1005 | 0.1uF | ＋80%, －20% | DC16V
GRM155F11A474Z | ○ | MURATA | 1005 | 0.47uF | ＋80%, －20% | DC10V
GRM155B30J105K | ○ | MURATA | 1005 | 1uF | ±10% | DC6.3V
GRM155F10J105Z | ○ | MURATA | 1005 | 1uF | ＋80%, －20% | DC6.3V
GRM1884C1HR50C | ○ | MURATA | 1608 | 0.5pF | ±0.25pF | DC50V
GRM1884C1H1R0C | ○ | MURATA | 1608 | 1pF | ±0.25pF | DC50V
GRM1884C1H2R0C | ○ | MURATA | 1608 | 2pF | ±0.25pF | DC50V
GRM1883C1H3R0C | ○ | MURATA | 1608 | 3pF | ±0.25pF | DC50V
GRM1882C1H4R0C | ○ | MURATA | 1608 | 4pF | ±0.25pF | DC50V
GRM1882C1H5R0C | ○ | MURATA | 1608 | 5pF | ±0.25pF | DC50V
GRM1882C1H6R0D | ○ | MURATA | 1608 | 6pF | ±0.5pF | DC50V
GRM1882C1H7R0D | ○ | MURATA | 1608 | 7pF | ±0.5pF | DC50V
GRM1882C1H8R0D | ○ | MURATA | 1608 | 8pF | ±0.5pF | DC50V
GRM1882C1H9R0D | ○ | MURATA | 1608 | 9pF | ±0.5pF | DC50V
GRM1882C1H100J | ○ | MURATA | 1608 | 10pF | ±5% | DC50V
GRM1882C1H120J | ○ | MURATA | 1608 | 12pF | ±5% | DC50V
GRM1882C1H150J | ○ | MURATA | 1608 | 15pF | ±5% | DC50V
GRM1882C1H180J | ○ | MURATA | 1608 | 18pF | ±5% | DC50V
GRM1882C1H200J | ○ | MURATA | 1608 | 20pF | ±5% | DC50V
GRM1882C1H220J | ○ | MURATA | 1608 | 22pF | ±5% | DC50V
GRM1882C1H270J | ○ | MURATA | 1608 | 27pF | ±5% | DC50V
GRM1882C1H330J | ○ | MURATA | 1608 | 33pF | ±5% | DC50V
GRM1882C1H390J | ○ | MURATA | 1608 | 39pF | ±5% | DC50V
GRM1882C1H470J | ○ | MURATA | 1608 | 47pF | ±5% | DC50V
GRM1882C1H560J | ○ | MURATA | 1608 | 56pF | ±5% | DC50V
GRM1882C1H680J | ○ | MURATA | 1608 | 68pF | ±5% | DC50V
GRM1882C1H820J | ○ | MURATA | 1608 | 82pF | ±5% | DC50V
GRM1882C1H101J | ○ | MURATA | 1608 | 100pF | ±5% | DC50V
GRM1882C1H121J | ○ | MURATA | 1608 | 120pF | ±5% | DC50V
GRM1882C1H151J | ○ | MURATA | 1608 | 150pF | ±5% | DC50V
GRM1882C1H181J | ○ | MURATA | 1608 | 180pF | ±5% | DC50V
GRM1882C1H221J | ○ | MURATA | 1608 | 220pF | ±5% | DC50V
GRM188B11H221K | ○ | MURATA | 1608 | 220pF | ±10% | DC50V
GRM1882C1H271J | ○ | MURATA | 1608 | 270pF | ±5% | DC50V
GRM188B11H271K | ○ | MURATA | 1608 | 270pF | ±10% | DC50V
GRM1882C1H331J | ○ | MURATA | 1608 | 330pF | ±5% | DC50V
GRM188B11H331K | ○ | MURATA | 1608 | 330pF | ±10% | DC50V
GRM1882C1H391J | ○ | MURATA | 1608 | 390pF | ±5% | DC50V
GRM188B11H391K | ○ | MURATA | 1608 | 390pF | ±10% | DC50V
GRM1882C1H471J | ○ | MURATA | 1608 | 470pF | ±5% | DC50V
GRM188B11H471K | ○ | MURATA | 1608 | 470pF | ±10% | DC50V
GRM1882C1H561J | ○ | MURATA | 1608 | 560pF | ±5% | DC50V
GRM188B11H561K | ○ | MURATA | 1608 | 560pF | ±10% | DC50V
GRM1882C1H681J | ○ | MURATA | 1608 | 680pF | ±5% | DC50V
GRM188B11H681K | ○ | MURATA | 1608 | 680pF | ±10% | DC50V
GRM1882C1H821J | ○ | MURATA | 1608 | 820pF | ±5% | DC50V
GRM188B11H821K | ○ | MURATA | 1608 | 820pF | ±10% | DC50V
GRM1882C1H102J | ○ | MURATA | 1608 | 1000pF | ±5% | DC50V
GRM188B11H102K | ○ | MURATA | 1608 | 1000pF | ±10% | DC50V
GRM1882C1H122J | ○ | MURATA | 1608 | 1200pF | ±5% | DC50V
GRM188B11H122K | ○ | MURATA | 1608 | 1200pF | ±10% | DC50V
GRM1882C1H152J | ○ | MURATA | 1608 | 1500pF | ±5% | DC50V
GRM188B11H152K | ○ | MURATA | 1608 | 1500pF | ±10% | DC50V
GRM1882C1H182J | ○ | MURATA | 1608 | 1800pF | ±5% | DC50V
GRM188B11H182K | ○ | MURATA | 1608 | 1800pF | ±10% | DC50V
GRM1882C1H222J | ○ | MURATA | 1608 | 2200pF | ±5% | DC50V
GRM188B11H222K | ○ | MURATA | 1608 | 2200pF | ±10% | DC50V
GRM1882C1H272J | ○ | MURATA | 1608 | 2700pF | ±5% | DC50V
GRM188B11H272K | ○ | MURATA | 1608 | 2700pF | ±10% | DC50V
GRM188B11H332K | ○ | MURATA | 1608 | 3300pF | ±10% | DC50V
GRM188B11H392K | ○ | MURATA | 1608 | 3900pF | ±10% | DC50V
GRM188B11H472K | ○ | MURATA | 1608 | 4700pF | ±10% | DC50V
GRM188B11H562K | ○ | MURATA | 1608 | 5600pF | ±10% | DC50V
GRM188B11H682K | ○ | MURATA | 1608 | 6800pF | ±10% | DC50V
GRM188B11H822K | ○ | MURATA | 1608 | 8200pF | ±10% | DC50V
GRM188B11H103K | ○ | MURATA | 1608 | 0.01uF | ±10% | DC50V
GRM188F11H103Z | ○ | MURATA | 1608 | 0.01uF | ＋80%, －20% | DC50V
GRM188B11H123K | ○ | MURATA | 1608 | 0.012uF | ±10% | DC50V
GRM188B11H153K | ○ | MURATA | 1608 | 0.015uF | ±10% | DC50V
GRM188F11H153Z | ○ | MURATA | 1608 | 0.015uF | ＋80%, －20% | DC50V
GRM188B11H183K | ○ | MURATA | 1608 | 0.018uF | ±10% | DC50V
GRM188F11H223Z | ○ | MURATA | 1608 | 0.022uF | ＋80%, －20% | DC50V
GRM188B11H223K | ○ | MURATA | 1608 | 0.022uF | ±10% | DC50V
GRM188B11E273K | ○ | MURATA | 1608 | 0.027uF | ±10% | DC25V
GRM188B11E333K | ○ | MURATA | 1608 | 0.033uF | ±10% | DC25V
GRM188F11H333Z | ○ | MURATA | 1608 | 0.033uF | ＋80%, －20% | DC50V
GRM188B11H333K | ○ | MURATA | 1608 | 0.033uF | ±10% | DC50V
GRM188B11E393K | ○ | MURATA | 1608 | 0.039uF | ±10% | DC25V
GRM188B11E473K | ○ | MURATA | 1608 | 0.047uF | ±10% | DC25V
GRM188F11H473Z | ○ | MURATA | 1608 | 0.047uF | ＋80%, －20% | DC50V
GRM188B11E563K | ○ | MURATA | 1608 | 0.056uF | ±10% | DC25V
GRM188B11E683K | ○ | MURATA | 1608 | 0.068uF | ±10% | DC25V
GRM188B11C823K | ○ | MURATA | 1608 | 0.082uF | ±10% | DC16V
GRM188B31H104K | ○ | MURATA | 1608 | 0.1uF | ±10% | DC50V
GRM188F11H104Z | ○ | MURATA | 1608 | 0.1uF | ＋80%, －20% | DC50V
GRM188B11E104K | ○ | MURATA | 1608 | 0.1uF | ±10% | DC25V
GRM188B11A124K | ○ | MURATA | 1608 | 0.12uF | ±10% | DC10V
GRM188B11A154K | ○ | MURATA | 1608 | 0.15uF | ±10% | DC10V
GRM188F11C154Z | ○ | MURATA | 1608 | 0.15uF | ＋80%, －20% | DC16V
GRM188B11A224K | ○ | MURATA | 1608 | 0.22uF | ±10% | DC10V
GRM188F11C224Z | ○ | MURATA | 1608 | 0.22uF | ＋80%, －20% | DC16V
GRM188B11A334K | ○ | MURATA | 1608 | 0.33uF | ±10% | DC10V
GRM188F11C334Z | ○ | MURATA | 1608 | 0.33uF | ＋80%, －20% | DC16V
GRM188B11A474K | ○ | MURATA | 1608 | 0.47uF | ±10% | DC10V
GRM188F11C474Z | ○ | MURATA | 1608 | 0.47uF | ＋80%, －20% | DC16V
GRM188F11A684Z | ○ | MURATA | 1608 | 0.68uF | ＋80%, －20% | DC10V
GRM188B11A105K | ○ | MURATA | 1608 | 1uF | ±10% | DC10V
GRM188F11A105Z | ○ | MURATA | 1608 | 1uF | ＋80%, －20% | DC10V
GRM188B31E105K | ○ | MURATA | 1608 | 1uF | ±10% | DC25V
GRM188B10J225K | ○ | MURATA | 1608 | 2.2uF | ±10% | DC6.3V
GRM2162C1H101J | ○ | MURATA | 2012 | 100pF | ±5% | DC50V
GRM2162C1H151J | ○ | MURATA | 2012 | 150pF | ±5% | DC50V
GRM2162C1H201J | ○ | MURATA | 2012 | 200pF | ±5% | DC50V
GRM2162C1H471J | ○ | MURATA | 2012 | 470pF | ±5% | DC50V
GRM2192C1H821J | ○ | MURATA | 2012 | 820pF | ±5% | DC50V
GRM2162C1H102J | ○ | MURATA | 2012 | 1000pF | ±5% | DC50V
GRM2162C1H222J | ○ | MURATA | 2012 | 2200pF | ±5% | DC50V
GRM2162B1H332K | ○ | MURATA | 2012 | 3300pF | ±10% | DC50V
GRM2162C1H332J | ○ | MURATA | 2012 | 3300pF | ±5% | DC50V
GRM219B11H333K | ○ | MURATA | 2012 | 0.033uF | ±10% | DC50V
GRM21BB11E104K | ○ | MURATA | 2012 | 0.1uF | ±10% | DC25V
GRM219F11H104Z | ○ | MURATA | 2012 | 0.1uF | ＋80%, －20% | DC50V
GRM2162F11E154Z | ○ | MURATA | 2012 | 0.15uF | ＋80%, －20% | DC25V
GRM21BF11E334Z | ○ | MURATA | 2012 | 0.33uF | ＋80%, －20% | DC25V
GRM219B11C474K | ○ | MURATA | 2012 | 0.47uF | ±10% | DC16V
GRM21BB11C105K | ○ | MURATA | 2012 | 1uF | ±10% | DC16V
GRM219F11C105Z | ○ | MURATA | 2012 | 1uF | ＋80%, －20% | DC16V
GRM21BB11A225K | ○ | MURATA | 2012 | 2.2uF | ±10% | DC10V
GRM21BB31E475K | ○ | MURATA | 2012 | 4.7uF | ±10% | DC25V
GRM21BB10J106K | ○ | MURATA | 2012 | 10uF | ±10% | DC6.3V
GRM21BB31A106K | ○ | MURATA | 2012 | 10uF | ±10% | DC10V
GRM21BB30J226M | ○ | MURATA | 2012 | 22uF | ±20% | DC6.3V
GRM319R11H104K | ○ | MURATA | 3216 | 0.1uF | ±10% | DC50V
GRM319B11H104K | ○ | MURATA | 3216 | 0.1uF | ±10% | DC50V
GRM319R72A104K | ○ | MURATA | 3216 | 0.1uF | ±10% | DC100V
GRM319R71H104K | ○ | MURATA | 3216 | 0.1uF | ±10% | DC50V
GRM319F11H104Z | ○ | MURATA | 3216 | 0.1uF | ＋80%, －20% | DC50V
GRM31MB11H224K | ○ | MURATA | 3216 | 0.22uF | ±10% | DC50V
GRM319B11C474K | ○ | MURATA | 3216 | 0.47uF | ±10% | DC16V
GRM31MB11C105K | ○ | MURATA | 3216 | 1uF | ±10% | DC16V
GRM31MB11E105K | ○ | MURATA | 3216 | 1uF | ±10% | DC25V
GRM31MB31H105K | ○ | MURATA | 3216 | 1uF | ±10% | DC50V
GRM31MF11E225Z | ○ | MURATA | 3216 | 2.2uF | ＋80%, －20% | DC25V
GRM31MB11C225K | ○ | MURATA | 3216 | 2.2uF | ±10% | DC16V
GRM31MF11C475Z | ○ | MURATA | 3216 | 4.7uF | ＋80%, －20% | DC16V
GRM31CB11A106K | ○ | MURATA | 3216 | 10uF | ±10% | DC10V
GRM31CF11E106Z | ○ | MURATA | 3216 | 10uF | ±10% | DC25V
GRM32RB11H105K | ○ | MURATA | 3225 | 1uF | ±10% | DC50V
GRM32EB11A106K | ○ | MURATA | 3225 | 10uF | ±10% | DC10V
