ohmydigifab/OpenBLW/pcb/interface_board/gerber/pban/manufacturing_directions.xls

Sheet: ｶﾞｰﾊﾞｰﾌｫｰﾏｯﾄﾘｽﾄ
※太枠の中のみ、ご記入ください |  | ※ご注文前に、是非ご参照ください。
ガーバー形式をお選びください |  | 御支給の基板製造データに、下記のような箇所が見受けられた場合、
 |  | 弊社P板.comサポート窓口より、その製造の可否についてお問い合わせさせていただいております。
データ内容 | ファイル名 | このままの製造で構わないという場合、ご注文の際の【お客様指示欄】に
ドリルデータ | main_controller_board.dri | 「○○は問題ない」という旨のご記載をいただくと、スムーズに注文が完了します。
ドリルリスト | main_controller_board.drd
ドリルデータ（分かれている場合） |  | ●外形寸法の入力の誤りがある場合
ドリルリスト（分かれている場合） |  | ⇒お客様にお問い合わせのご連絡をさせていただきます。
部品面パターン | main_controller_board.cmp | 弊社では、外形寸法はX方向、Y方向それぞれの最大値をご入力いただいております。
半田面パターン | main_controller_board.sol | 小数点第一位までご入力ください。
部品面レジスト | main_controller_board.stc | 外形線の作成は、外形線の中心が基準となるよう、製造データの作成をお願いします。
半田面レジスト | main_controller_board.sts
部品面シルク | main_controller_board.plc
半田面シルク | main_controller_board.pls
外形線図 | main_controller_board.out
Ｌ２内層パターン（４，６，８層板のみ要） | main_controller_board.2l
Ｌ３内層パターン（４，６，８層板のみ要） | main_controller_board.3l
Ｌ４内層パターン（６，８層板のみ要）
Ｌ５内層パターン（６，８層板のみ要）
Ｌ６内層パターン（８層板のみ要）
Ｌ７内層パターン（８層板のみ要）
●レジストデータの間隔が0.1mm未満の場合 |  | ●外形線とパターンの間隔が0.3mm未満の箇所がある場合
⇒レジスト液がきれいに塗られない可能性があります。 |  | ⇒基板サイドから銅箔がはみ出してバリが発生し、他の基板を傷つける可能性があります。
●Vカットセンターから銅箔（パターン、ベタ）までが1.0mm未満の場合 |  | ●スリット線または外形とV カットとが線上で接している場合
⇒Vカットが銅箔をかじり、パターンを破断してしまう可能性があります。 |  | ⇒Vカットがずれてしまう可能性があります。

Sheet: ｱﾊﾟﾁｬﾘｽﾄ（Dｺｰﾄﾞ表）
※RS-274X（拡張ガーバー形式）で出力した場合は必要ございません。 本シートに入力せずデータファイルをご登録いただいても結構です。
Dコード | 形状 | サイズ1(X) | サイズ2(Y) | サイズ3(Z)
D10 | Round | 0.6 |  |  | Round=円形
D11 | Square | 0.6 |  |  | Square=四角
D12 | Rectangl | 0.6 | 2 |  | Rectangle=長方形
D13 | Oblong | 2 | 0.6 |  | Oblong＝楕円
D14 | Thermal | 2 | 1.5 | 0.2 | Thermal=サーマル
 |  |  |  |  | 長方形と楕円
 |  |  |  |  | サーマル
 |  |  |  |  |  | X
 |  |  |  |  |  | Y
 |  |  |  |  |  | Z

Sheet: 外形図
※外形寸法が入った外形図をご登録下さい。 本シートに貼り付けずデータファイルをご登録いただいても結構です。
