ohmydigifab/OpenBLW/hardware/raspberry_pi_model_B.stl

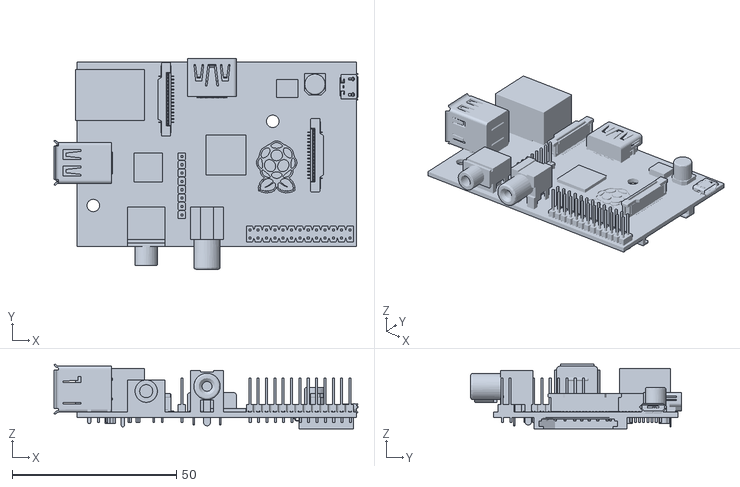
[picture p2: CAD file, 2015-08-06]
hardware/raspberry_pi_model_B.stl
92.5 x 64.1 x 19.8
