ohmydigifab/OpenBLW/hardware/dome.scad

include<params.scad>

module dome()
{
    color([1,1,1,0.3])
    {
        difference() {
            sphere(r = r_from_dia(DOME_DIA));
            sphere(r = r_from_dia(DOME_DIA-DOME_THICK));
            translate([ -100, -100, -200.01 ])
                cube([200,200,200]);
        }

//        difference() {
//            cylinder(r = r_from_dia(DOME_DIA)+10, h = DOME_THICK);
//            translate([ 0, 0, -1 ])
//            cylinder(r = r_from_dia(DOME_DIA-DOME_THICK), h = DOME_THICK+2);
//        }
    }
}

dome();
