ohmydigifab/OpenBLW/(list of files, cad)

Other CAD files:
hardware/base_plate_middle.scad
hardware/dxf_3dot0mm_2.scad
hardware/dxf_5dot0mm_2.scad
hardware/camera_holder.scad
hardware/extlens_holder1.scad
hardware/extlens_holder2.scad
hardware/extlens_holder3.scad
hardware/oring_holder.scad
hardware/params.scad
