ohmydigifab/OpenBLW/pcb/interface_board/interface_board.brd

## EAGLE design pcb/interface_board/interface_board.brd (2016-03-31)

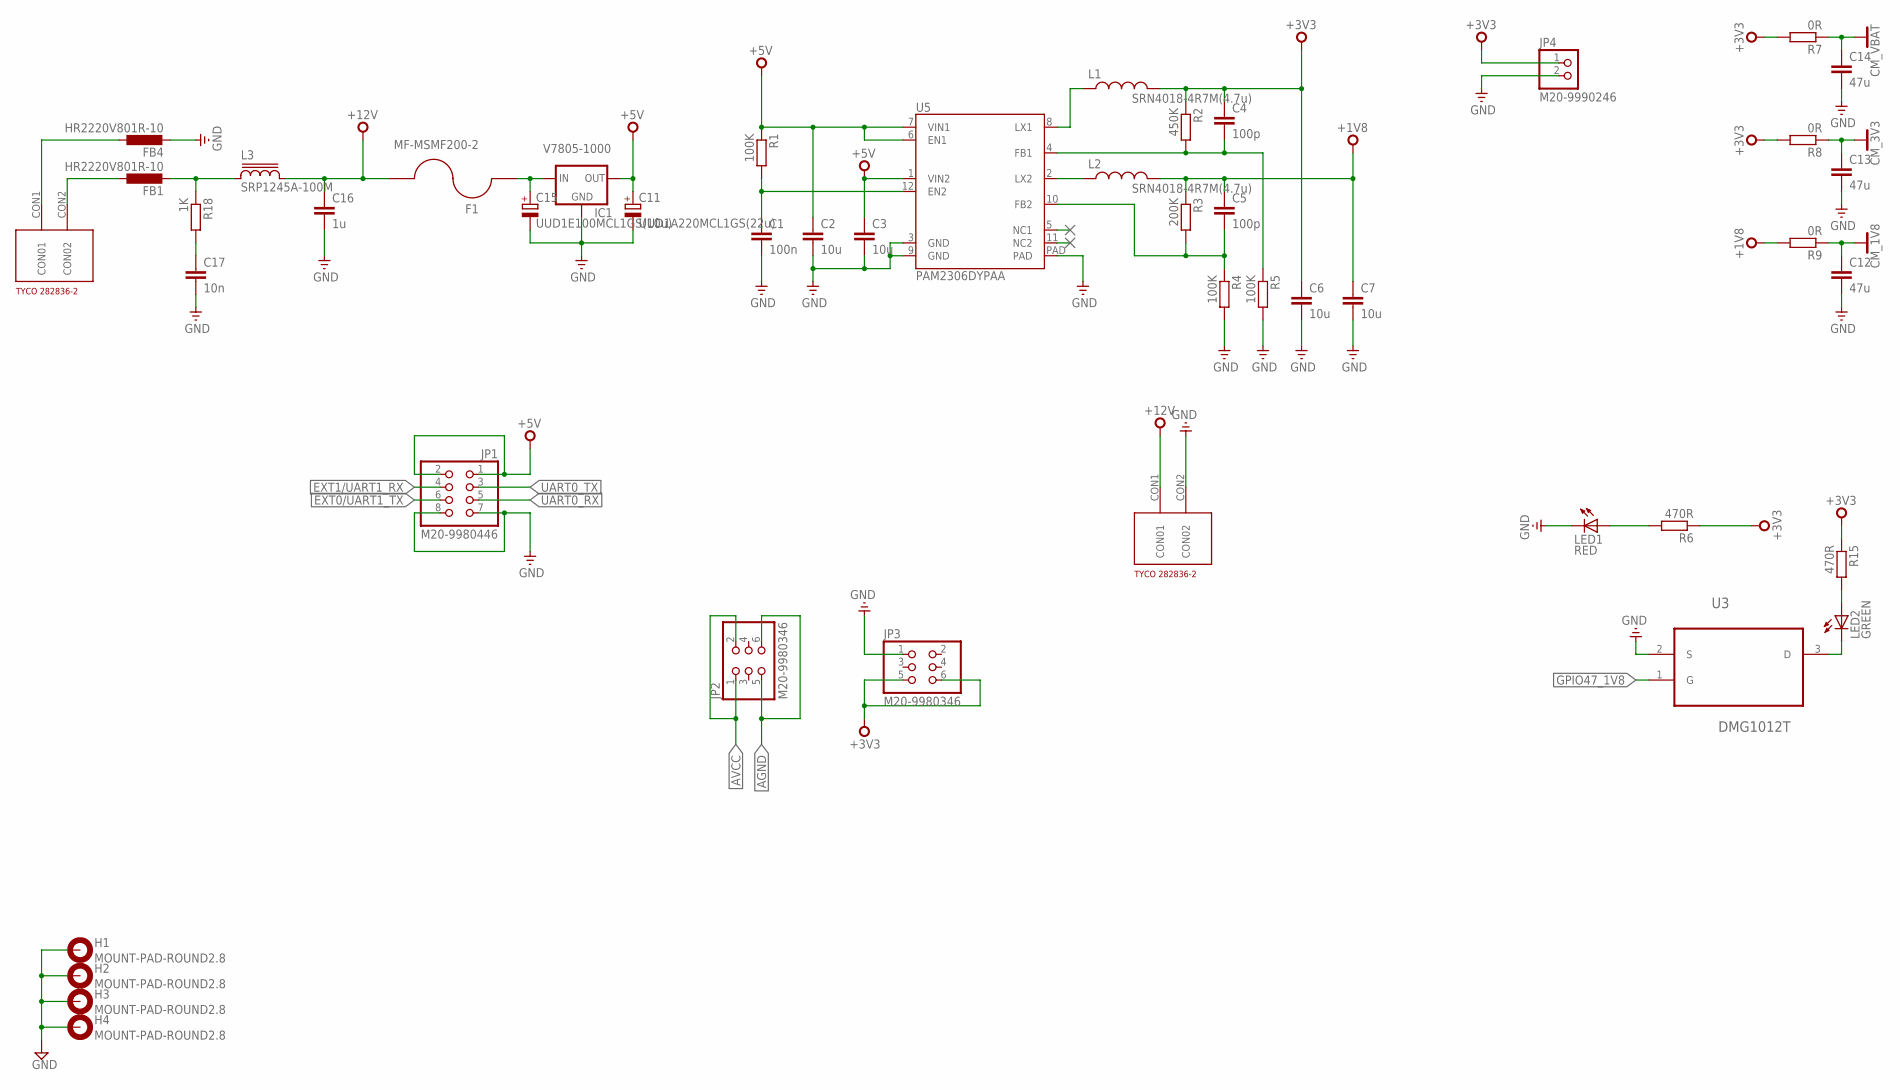
[picture p3: schematic interface_board.sch, sheet 1]

Parts:
C1: 100n; C0402
C2, C3, C6, C7: 10u; C0805
C4, C5: 100p; C0402
C11: UUD1A220MCL1GS(22u); 153CLV-0405
C12, C13, C14: 47u; C1206
C15: UUD1E100MCL1GS(10u); 153CLV-0405
C16: 1u; C0402
C17: 10n; C0402
F1: MF-MSMF200-2; 1812
FB1, FB4: HR2220V801R-10; L5650M
H1, H2, H3, H4: MOUNT-PAD-ROUND2.8; 2,8-PAD
IC1: V7805-1000; DIP_3PIN
JP1: M20-9980446; 2X04
JP2, JP3: M20-9980346; 2X03
JP4: M20-9990246; 1X02
L1, L2: SRN4018-4R7M(4.7u); BOURNS-SRN4018
L3: SRP1245A-100M; SRP1250A
LED1: RED; CHIP-LED0603
LED2: GREEN; CHIP-LED0603
R1, R4, R5: 100K; R0402
R2: 450K; R0402
R3: 200K; R0402
R6, R15: 470R; R0402
R7, R8, R9: 0R; R0805
R18: 1K; R0402
U3: DMG1012T; SOT523
U5: PAM2306DYPAA; WDFN3X3-12L
U$1: 282836-2
U$2: M20-9980346; 282836-2

Connections:
+1V8: C5.1, C7.1, L2.P$1 (1), R3.1, R9.2
+3V3: C4.1, C6.1, JP3.5, JP3.6, JP4.1, L1.P$1 (1), R2.1, R6.1, R7.2, R8.2, R15.1; also elsewhere on the board
+5V: C2.1, C3.1, C11.+, IC1.OUT, JP1.1, JP1.2, R1.1, U5.1 (VIN2), U5.6 (EN1), U5.7 (VIN1); also elsewhere on the board
+12V: C16.1, F1.1, L3.2, U$2.CON1 (CON01)
AGND: FB4.1, JP2.5, JP2.6, U$1.CON1 (CON01)
AVCC: FB1.1, JP2.1, JP2.2, U$1.CON2 (CON02)
CM_1V8: C12.1, R9.1; also elsewhere on the board
CM_3V3: C13.1, R8.1; also elsewhere on the board
CM_VBAT: C14.1, R7.1; also elsewhere on the board
EXT0/UART1_TX: JP1.6; also elsewhere on the board
EXT1/UART1_RX: JP1.4; also elsewhere on the board
GND: C1.2, C2.2, C3.2, C6.2, C7.2, C11.-, C12.2, C13.2, C14.2, C15.-, C16.2, C17.2, FB4.2, H1.B2,8, H2.B2,8, H3.B2,8, H4.B2,8, IC1.GND, JP1.7, JP1.8, JP3.1, JP4.2, LED1.C, R4.2, R5.2, U3.2 (S), U5.3 (GND), U5.9 (GND), U5.PAD, U$2.CON2 (CON02); also elsewhere on the board
GPIO47_1V8: U3.1 (G); also elsewhere on the board
unnamed: C1.1, R1.2, U5.12 (EN2)
unnamed: L1.P$2 (2), U5.8 (LX1)
unnamed: FB1.2, L3.1, R18.1
unnamed: L2.P$2 (2), U5.2 (LX2)
unnamed: C4.2, R2.2, R5.1, U5.4 (FB1)
unnamed: LED1.A, R6.2
unnamed: C5.2, R3.2, R4.1, U5.10 (FB2)
unnamed: LED2.A, R15.2
unnamed: LED2.C, U3.3 (D)
unnamed: C17.1, R18.2
unnamed: C15.+, F1.2, IC1.IN
UART0_RX: JP1.5; also elsewhere on the board
UART0_TX: JP1.3; also elsewhere on the board

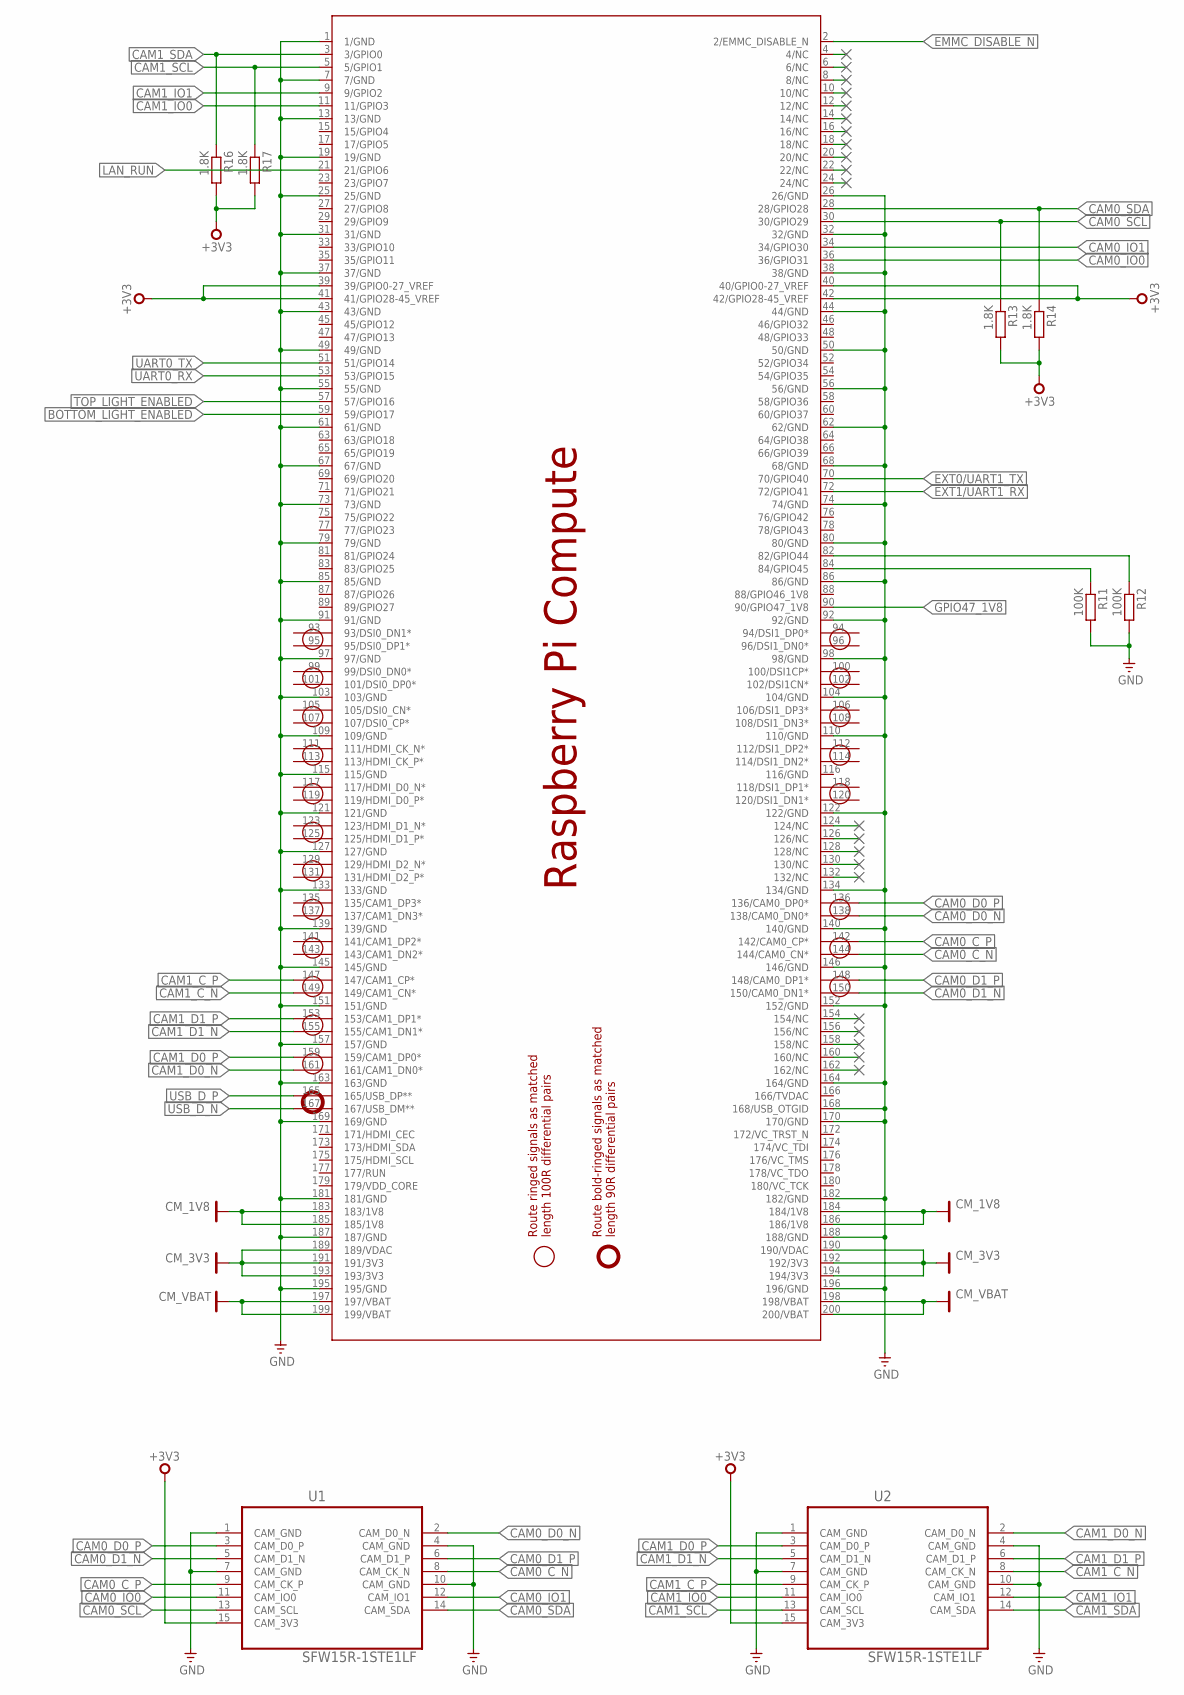
[picture p4: schematic interface_board.sch, sheet 2]

Parts:
PCB1: 1473005-4; RPI_COMPUTE
R11, R12: 100K; R0402
R13, R14, R16, R17: 1.8K; R0402
U1, U2: SFW15R-1STE1LF; RPI_CAMERA

Connections:
+3V3: PCB1.39 (39/GPIO0-27_VREF), PCB1.40 (40/GPIO0-27_VREF), PCB1.41 (41/GPIO28-45_VREF), PCB1.42 (42/GPIO28-45_VREF), R13.2, R14.2, R16.2, R17.2, U1.15 (CAM_3V3), U2.15 (CAM_3V3); also elsewhere on the board
BOTTOM_LIGHT_ENABLED: PCB1.59 (59/GPIO17)
CAM0_C_N: PCB1.144 (144/CAM0_CN*), U1.8 (CAM_CK_N)
CAM0_C_P: PCB1.142 (142/CAM0_CP*), U1.9 (CAM_CK_P)
CAM0_D0_N: PCB1.138 (138/CAM0_DN0*), U1.2 (CAM_D0_N)
CAM0_D0_P: PCB1.136 (136/CAM0_DP0*), U1.3 (CAM_D0_P)
CAM0_D1_N: PCB1.150 (150/CAM0_DN1*), U1.5 (CAM_D1_N)
CAM0_D1_P: PCB1.148 (148/CAM0_DP1*), U1.6 (CAM_D1_P)
CAM0_IO0: PCB1.36 (36/GPIO31), U1.11 (CAM_IO0)
CAM0_IO1: PCB1.34 (34/GPIO30), U1.12 (CAM_IO1)
CAM0_SCL: PCB1.30 (30/GPIO29), R13.1, U1.13 (CAM_SCL)
CAM0_SDA: PCB1.28 (28/GPIO28), R14.1, U1.14 (CAM_SDA)
CAM1_C_N: PCB1.149 (149/CAM1_CN*), U2.8 (CAM_CK_N)
CAM1_C_P: PCB1.147 (147/CAM1_CP*), U2.9 (CAM_CK_P)
CAM1_D0_N: PCB1.161 (161/CAM1_DN0*), U2.2 (CAM_D0_N)
CAM1_D0_P: PCB1.159 (159/CAM1_DP0*), U2.3 (CAM_D0_P)
CAM1_D1_N: PCB1.155 (155/CAM1_DN1*), U2.5 (CAM_D1_N)
CAM1_D1_P: PCB1.153 (153/CAM1_DP1*), U2.6 (CAM_D1_P)
CAM1_IO0: PCB1.11 (11/GPIO3), U2.11 (CAM_IO0)
CAM1_IO1: PCB1.9 (9/GPIO2), U2.12 (CAM_IO1)
CAM1_SCL: PCB1.5 (5/GPIO1), R17.1, U2.13 (CAM_SCL)
CAM1_SDA: PCB1.3 (3/GPIO0), R16.1, U2.14 (CAM_SDA)
CM_1V8: PCB1.183 (183/1V8), PCB1.184 (184/1V8), PCB1.185 (185/1V8), PCB1.186 (186/1V8); also elsewhere on the board
CM_3V3: PCB1.189 (189/VDAC), PCB1.190 (190/VDAC), PCB1.191 (191/3V3), PCB1.192 (192/3V3), PCB1.193 (193/3V3), PCB1.194 (194/3V3); also elsewhere on the board
CM_VBAT: PCB1.197 (197/VBAT), PCB1.198 (198/VBAT), PCB1.199 (199/VBAT), PCB1.200 (200/VBAT); also elsewhere on the board
EMMC_DISABLE_N: PCB1.2 (2/EMMC_DISABLE_N)
EXT0/UART1_TX: PCB1.70 (70/GPIO40); also elsewhere on the board
EXT1/UART1_RX: PCB1.72 (72/GPIO41); also elsewhere on the board
GND: PCB1.1 (1/GND), PCB1.7 (7/GND), PCB1.13 (13/GND), PCB1.19 (19/GND), PCB1.25 (25/GND), PCB1.26 (26/GND), PCB1.31 (31/GND), PCB1.32 (32/GND), PCB1.37 (37/GND), PCB1.38 (38/GND), PCB1.43 (43/GND), PCB1.44 (44/GND), PCB1.49 (49/GND), PCB1.50 (50/GND), PCB1.55 (55/GND), PCB1.56 (56/GND), PCB1.61 (61/GND), PCB1.62 (62/GND), PCB1.67 (67/GND), PCB1.68 (68/GND), PCB1.73 (73/GND), PCB1.74 (74/GND), PCB1.79 (79/GND), PCB1.80 (80/GND), PCB1.85 (85/GND), PCB1.86 (86/GND), PCB1.91 (91/GND), PCB1.92 (92/GND), PCB1.97 (97/GND), PCB1.98 (98/GND), PCB1.103 (103/GND), PCB1.104 (104/GND), PCB1.109 (109/GND), PCB1.110 (110/GND), PCB1.115 (115/GND), PCB1.121 (121/GND), PCB1.122 (122/GND), PCB1.127 (127/GND), PCB1.133 (133/GND), PCB1.134 (134/GND), PCB1.139 (139/GND), PCB1.140 (140/GND), PCB1.145 (145/GND), PCB1.146 (146/GND), PCB1.151 (151/GND), PCB1.152 (152/GND), PCB1.157 (157/GND), PCB1.163 (163/GND), PCB1.164 (164/GND), PCB1.168 (168/USB_OTGID), PCB1.169 (169/GND), PCB1.170 (170/GND), PCB1.181 (181/GND), PCB1.182 (182/GND), PCB1.187 (187/GND), PCB1.188 (188/GND), PCB1.195 (195/GND), PCB1.196 (196/GND), R11.2, R12.2, U1.1 (CAM_GND), U1.4 (CAM_GND), U1.7 (CAM_GND), U1.10 (CAM_GND), U2.1 (CAM_GND), U2.4 (CAM_GND), U2.7 (CAM_GND), U2.10 (CAM_GND); also elsewhere on the board
GPIO47_1V8: PCB1.90 (90/GPIO47_1V8); also elsewhere on the board
LAN_RUN: PCB1.21 (21/GPIO6); also elsewhere on the board
unnamed: PCB1.82 (82/GPIO44), R12.1
unnamed: PCB1.84 (84/GPIO45), R11.1
TOP_LIGHT_ENABLED: PCB1.57 (57/GPIO16)
UART0_RX: PCB1.53 (53/GPIO15); also elsewhere on the board
UART0_TX: PCB1.51 (51/GPIO14); also elsewhere on the board
USB_D_N: PCB1.167 (167/USB_DM**); also elsewhere on the board
USB_D_P: PCB1.165 (165/USB_DP**); also elsewhere on the board

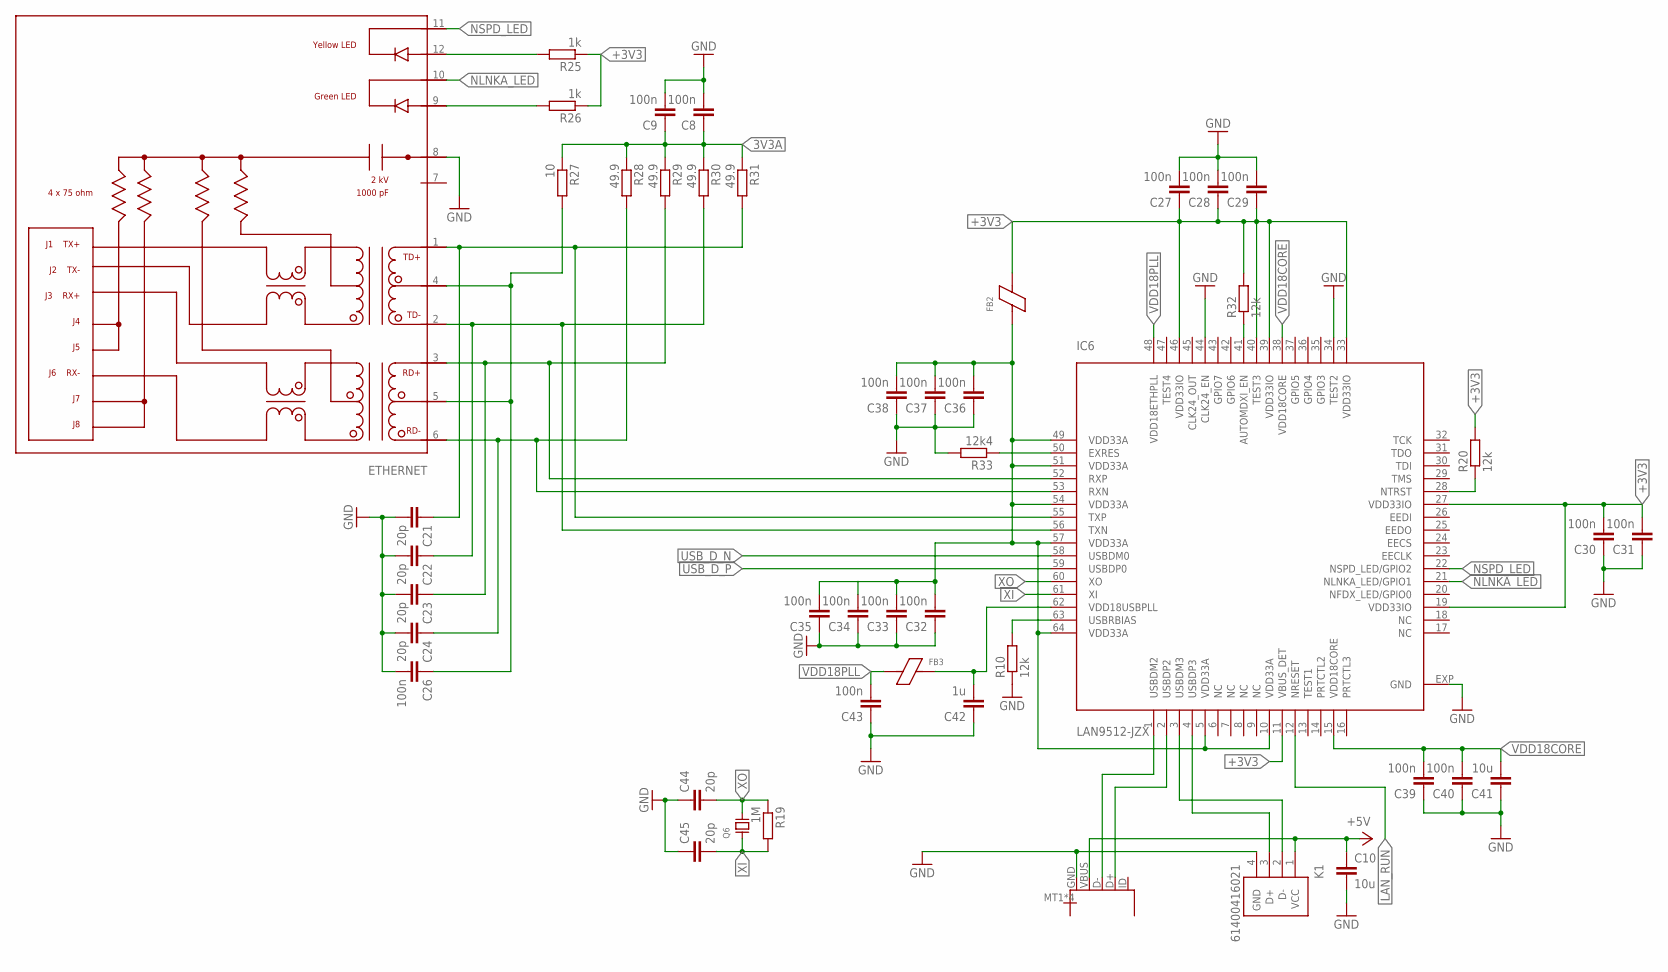
[picture p5: schematic interface_board.sch, sheet 3]

Parts:
C8, C9, C26, C27, C28, C29, C30, C31, C32, C33, C34, C35, C36, C37, C38, C39, C40, C43: 100n; C0603
C10, C41: 10u; C0805
C21, C22, C23, C24, C44, C45: 20p; C0603
C42: 1u; C0805
ETHERNET: HR911105A; RJ45
FB2, FB3: 742792022; C0805
IC6: LAN9512-JZX; QFN64-9X9
JP5: USB-IDMICRO; USB-MICRO
K1: 61400416021
Q6: CTS_32X25_SMD; CTS_32X25
R10, R20, R32: 12k; R0603
R19: 1M; R0603
R25, R26: 1k; R0603
R27: 10; R0603
R28, R29, R30, R31: 49.9; R0603
R33: 12k4; R0603

Connections:
3V3A: C8.1, C9.1, R27.1, R28.1, R29.1, R30.1, R31.1
3V3A1: C32.2, C33.2, C34.2, C35.2, C36.2, C37.2, C38.2, FB2.1, IC6.5 (VDD33A), IC6.10 (VDD33A), IC6.49 (VDD33A), IC6.51 (VDD33A), IC6.54 (VDD33A), IC6.57 (VDD33A), IC6.64 (VDD33A)
+3V3: C27.1, C28.1, C29.1, C30.2, C31.2, FB2.2, IC6.11 (VBUS_DET), IC6.19 (VDD33IO), IC6.27 (VDD33IO), IC6.33 (VDD33IO), IC6.39 (VDD33IO), IC6.40 (TEST3), IC6.46 (VDD33IO), R20.2, R25.1, R26.1, R32.2; also elsewhere on the board
+5V: C10.1, JP5.VBUS, K1.1 (VCC); also elsewhere on the board
GND: C8.2, C9.2, C10.2, C21.2, C22.2, C23.2, C24.2, C26.2, C27.2, C28.2, C29.2, C30.1, C31.1, C32.1, C33.1, C34.1, C35.1, C36.1, C37.1, C38.1, C39.1, C40.1, C41.1, C42.1, C43.1, C44.1, C45.1, ETHERNET.8, IC6.34 (TEST2), IC6.44 (CLK24_EN), IC6.EXP (GND), JP5.GND, K1.4 (GND), R10.1, R33.2; also elsewhere on the board
LAN_RUN: IC6.12 (NRESET); also elsewhere on the board
unnamed: ETHERNET.12, R25.2
unnamed: ETHERNET.9, R26.2
unnamed: C26.1, ETHERNET.4, ETHERNET.5, R27.2
unnamed: IC6.63 (USBRBIAS), R10.2
unnamed: C42.2, FB3.2, IC6.62 (VDD18USBPLL)
unnamed: IC6.41 (AUTOMDXI_EN), R32.1
unnamed: IC6.50 (EXRES), R33.1
unnamed: IC6.28 (NTRST), R20.1
unnamed: IC6.1 (USBDM2), JP5.D-
unnamed: IC6.2 (USBDP2), JP5.D+
NLNKA_LED: ETHERNET.10, IC6.21 (NLNKA_LED/GPIO1)
NSPD_LED: ETHERNET.11, IC6.22 (NSPD_LED/GPIO2)
RX_N: C24.1, ETHERNET.6, IC6.53 (RXN), R28.2
RX_P: C23.1, ETHERNET.3, IC6.52 (RXP), R29.2
TX_N: C22.1, ETHERNET.2, IC6.56 (TXN), R30.2
TX_P: C21.1, ETHERNET.1, IC6.55 (TXP), R31.2
USBD3_N: IC6.3 (USBDM3), K1.2 (D-)
USBD3_P: IC6.4 (USBDP3), K1.3 (D+)
USB_D_N: IC6.58 (USBDM0); also elsewhere on the board
USB_D_P: IC6.59 (USBDP0); also elsewhere on the board
VDD18CORE: C39.2, C40.2, C41.2, IC6.15 (VDD18CORE), IC6.38 (VDD18CORE)
VDD18PLL: C43.2, FB3.1, IC6.48 (VDD18ETHPLL)
XI: C45.2, IC6.61 (XI), Q6.1 (X1), R19.2
XO: C44.2, IC6.60 (XO), Q6.3 (X2), R19.1

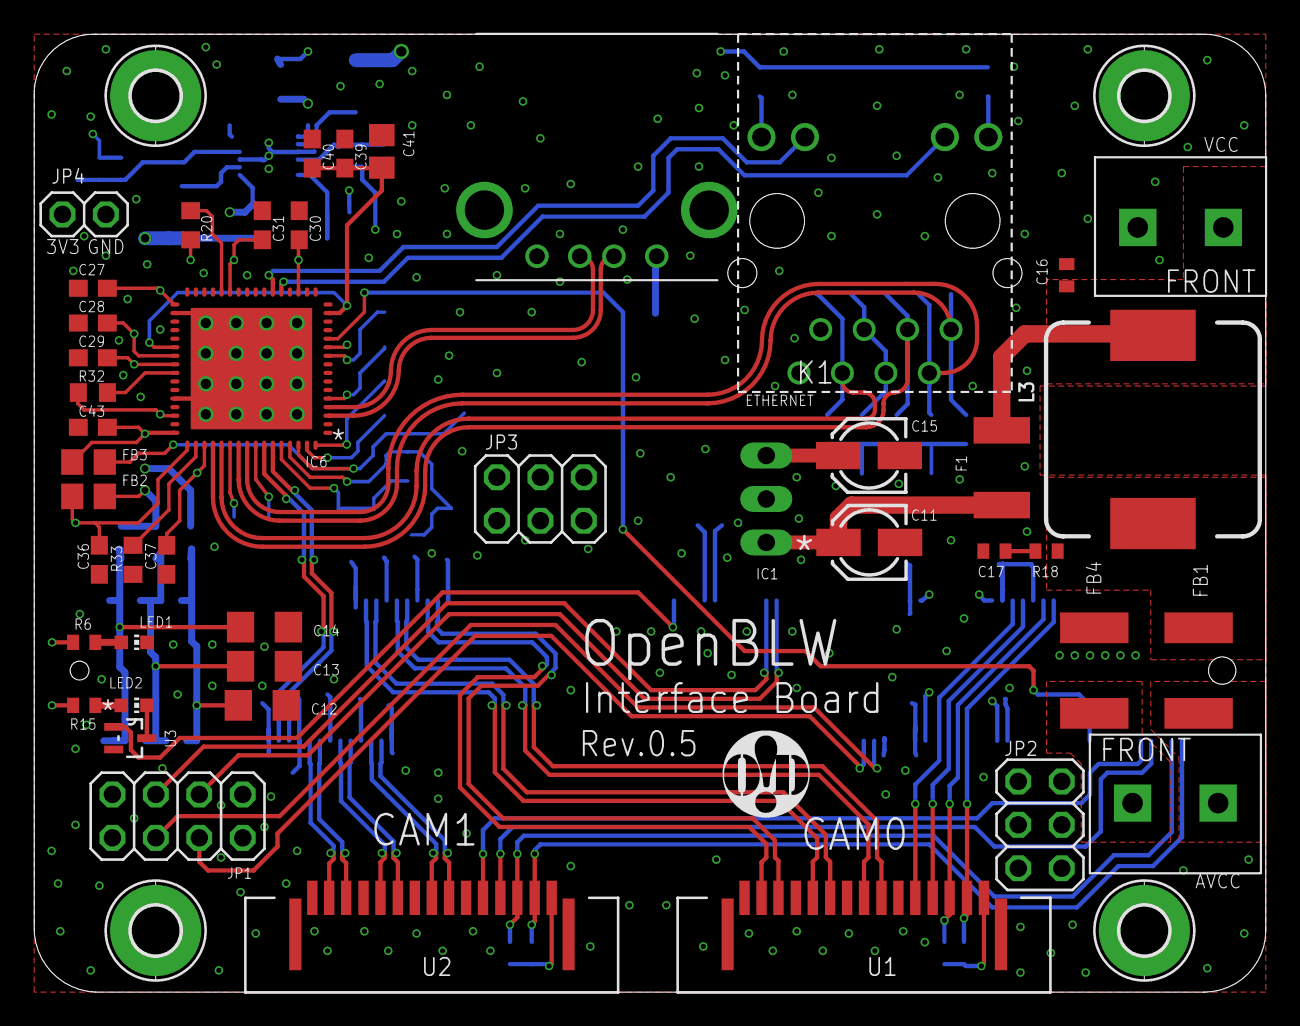
[picture p6: board interface_board.brd from above]

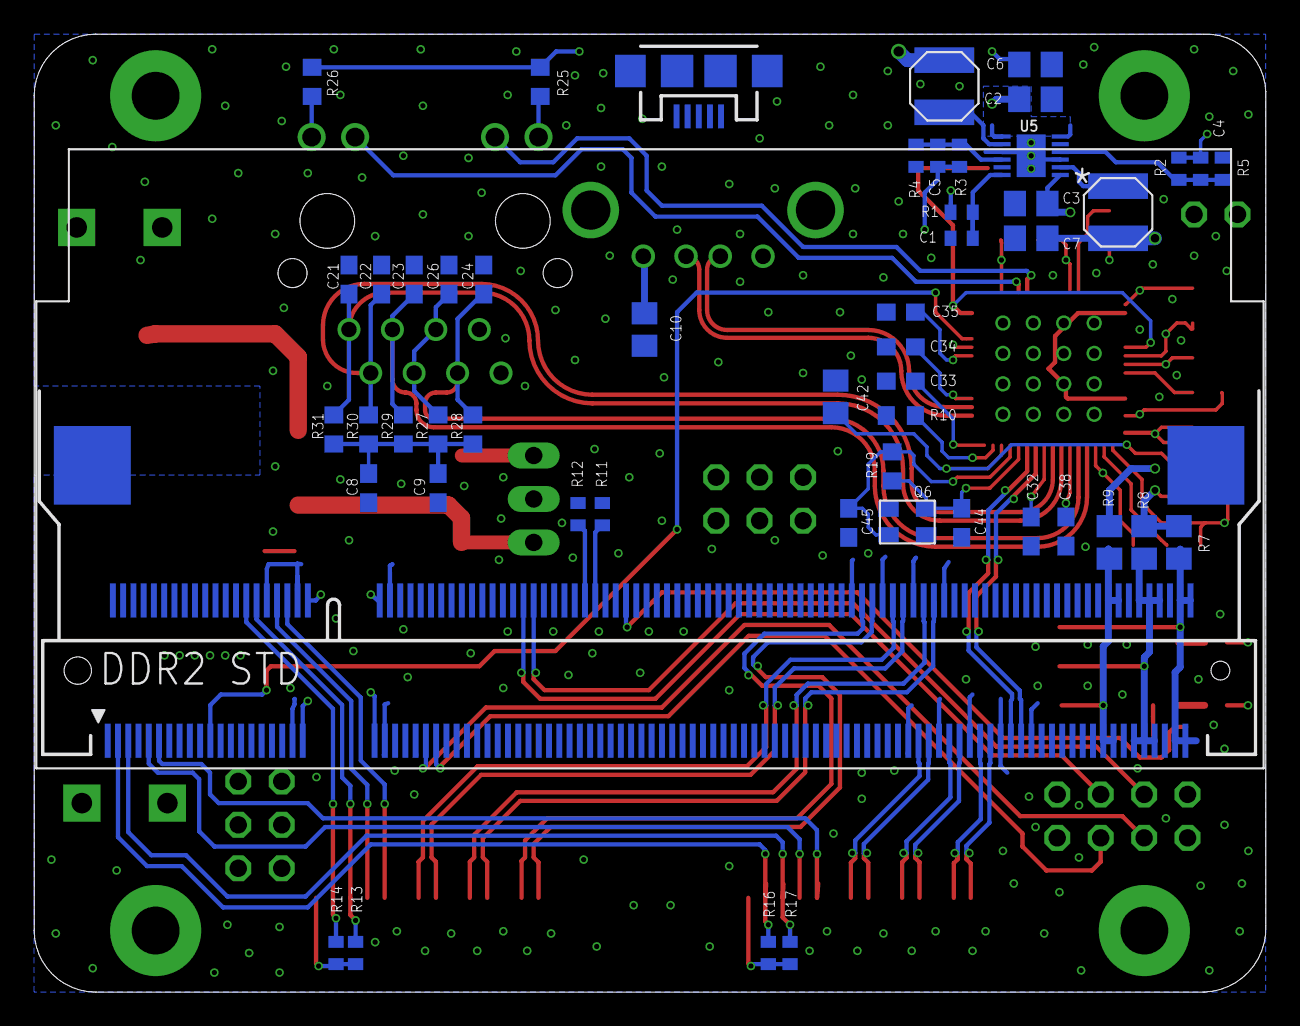
[picture p7: board interface_board.brd from below]

Board: 4 copper layers, 72.0 x 56.0 mm, 103 parts (52 on the bottom side), 75 nets.

Other parts of the board:
LOGO1: OHMYDIGIFAB_LOGO
U$3: TENDA_P200
