ohmydigifab/OpenBLW/pcb/driver_board/driver_board.brd

## EAGLE design pcb/driver_board/driver_board.brd (2016-02-17)

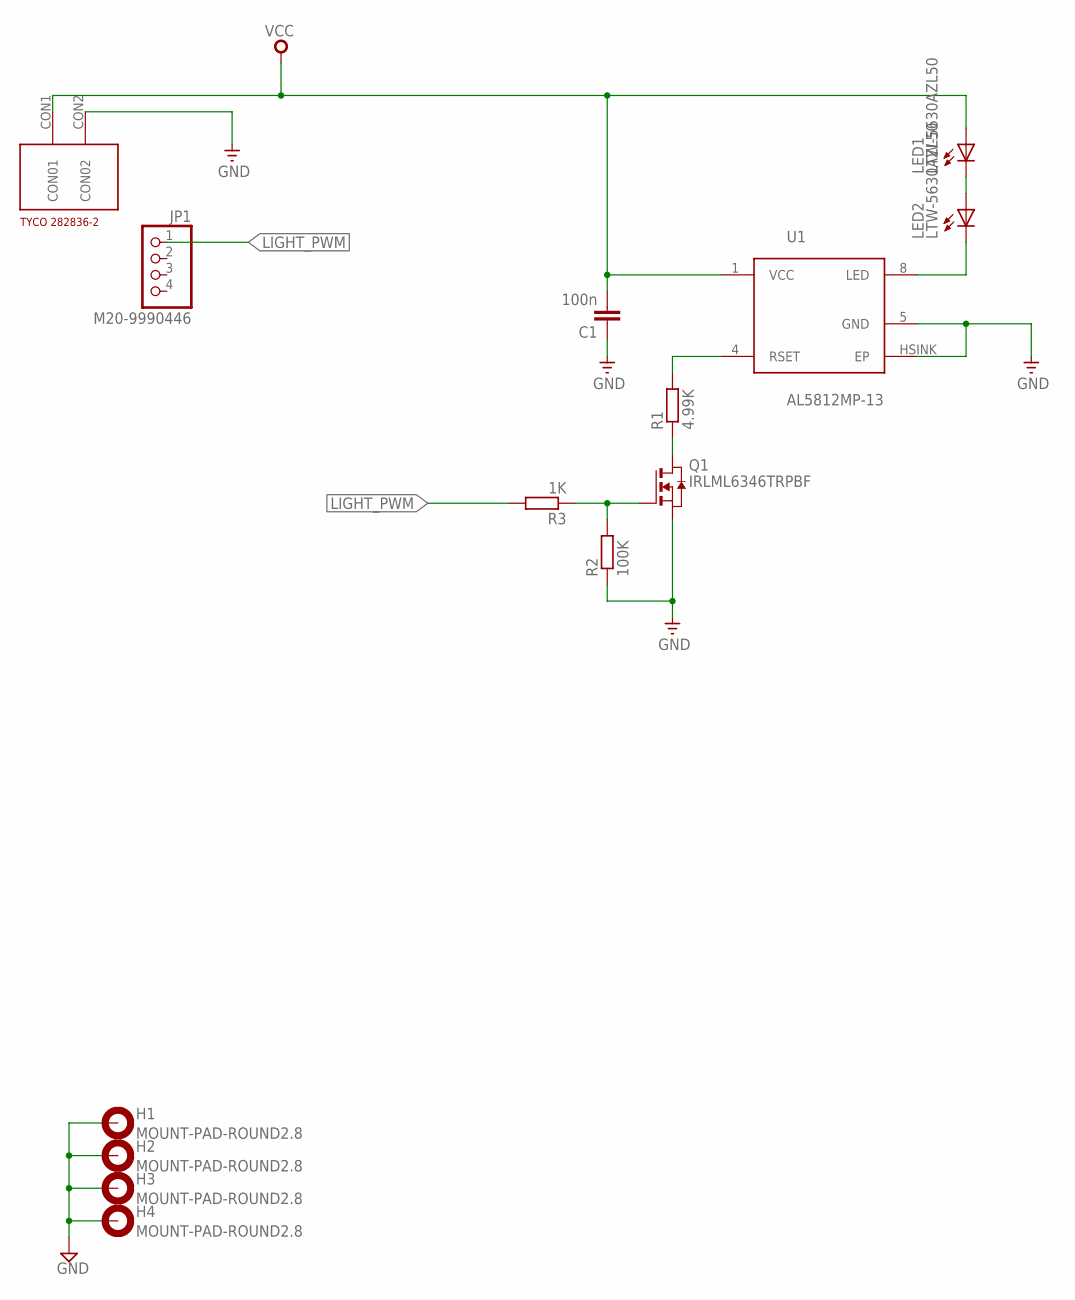
[picture p8: schematic driver_board.sch, sheet 1]

Parts:
C1: 100n; C0402
H1, H2, H3, H4: MOUNT-PAD-ROUND2.8; 2,8-PAD
JP1: M20-9990446; 1X04
LED1, LED2: LTW-5630AZL50; LITEON-5630
Q1: IRLML6346TRPBF; SOT23
R1: 4.99K; R0402
R2: 100K; R0402
R3: 1K; R0402
U1: AL5812MP-13; MSOP-8EP
U$1: 282836-2

Connections:
GND: C1.1, H1.B2,8, H2.B2,8, H3.B2,8, H4.B2,8, Q1.2 (S), R2.1, U1.5 (GND), U1.HSINK (EP), U$1.CON2 (CON02); also elsewhere on the board
LIGHT_PWM: JP1.1, R3.2
unnamed: LED1.C1 (C), LED1.C2 (C), LED2.A1 (A), LED2.A2 (A), LED2.A3 (A)
unnamed: R1.2, U1.4 (RSET)
unnamed: Q1.3 (D), R1.1
unnamed: Q1.1 (G), R2.2, R3.1
unnamed: LED2.C1 (C), LED2.C2 (C), U1.8 (LED)
VCC: C1.2, LED1.A1 (A), LED1.A2 (A), LED1.A3 (A), U1.1 (VCC), U$1.CON1 (CON01); also elsewhere on the board

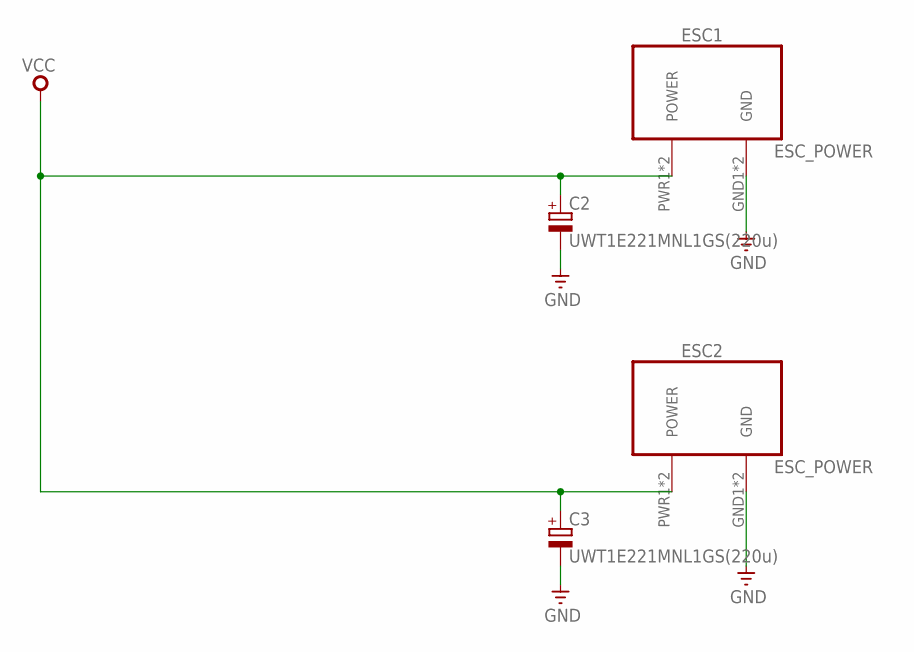
[picture p9: schematic driver_board.sch, sheet 2]

Parts:
C2, C3: UWT1E221MNL1GS(220u); 153CLV-0810
ESC1, ESC2: ESC_POWER

Connections:
GND: C2.-, C3.-, ESC1.GND1 (GND), ESC1.GND2 (GND), ESC2.GND1 (GND), ESC2.GND2 (GND); also elsewhere on the board
VCC: C2.+, C3.+, ESC1.PWR1 (POWER), ESC1.PWR2 (POWER), ESC2.PWR1 (POWER), ESC2.PWR2 (POWER); also elsewhere on the board

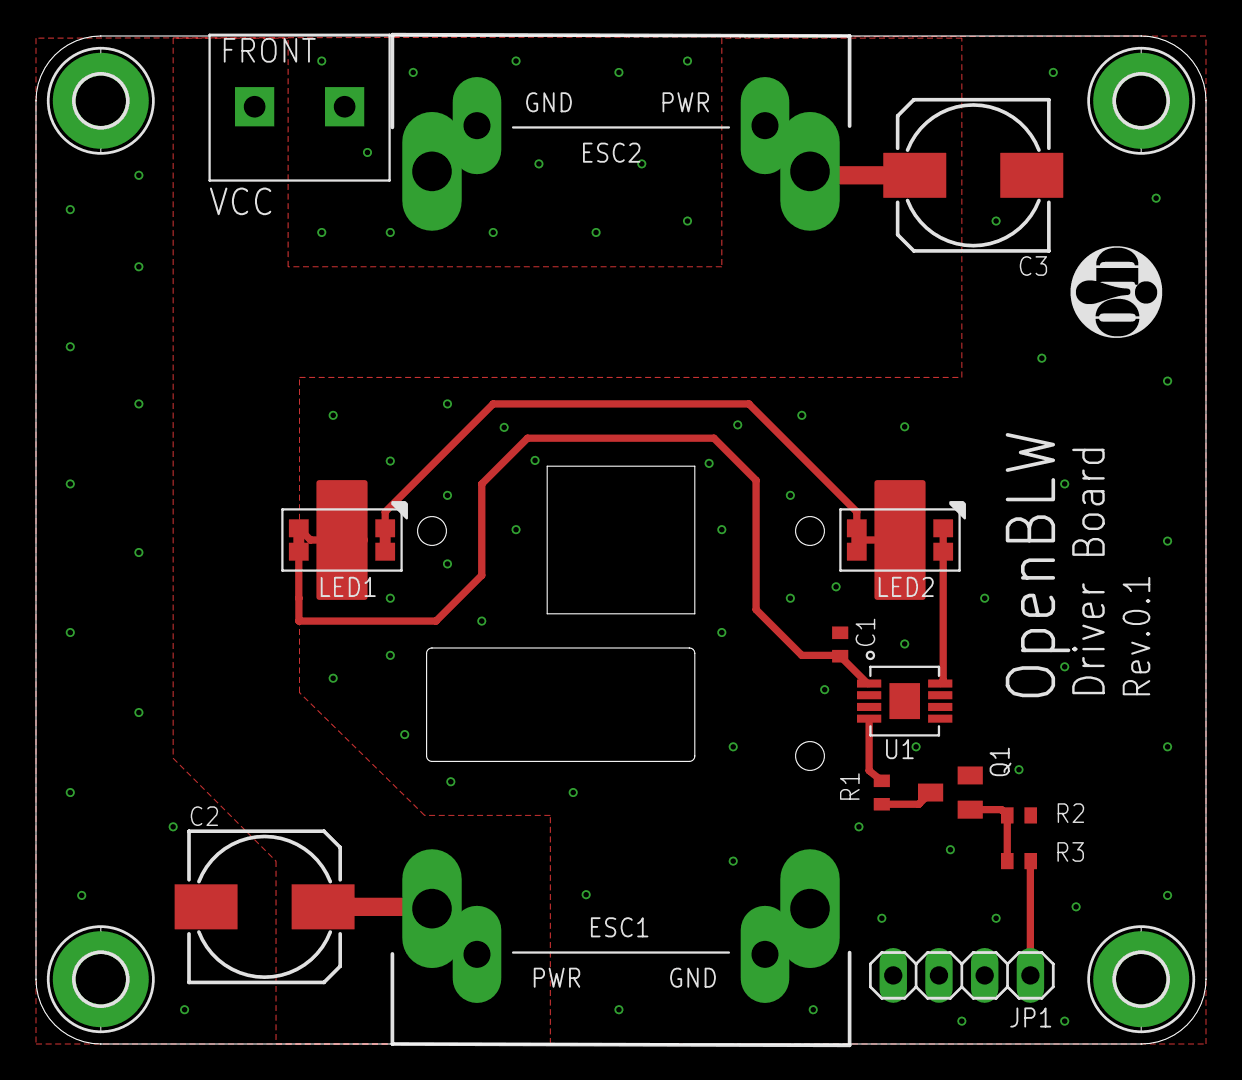
[picture p10: board driver_board.brd from above]

Board: 4 copper layers, 65.0 x 56.0 mm, 19 parts (0 on the bottom side), 8 nets.

Other parts of the board:
LOGO1: OHMYDIGIFAB_LOGO
