ohmydigifab/OpenBLW/pcb/client_board/client_board.brd

## EAGLE design pcb/client_board/client_board.brd (2016-02-17)

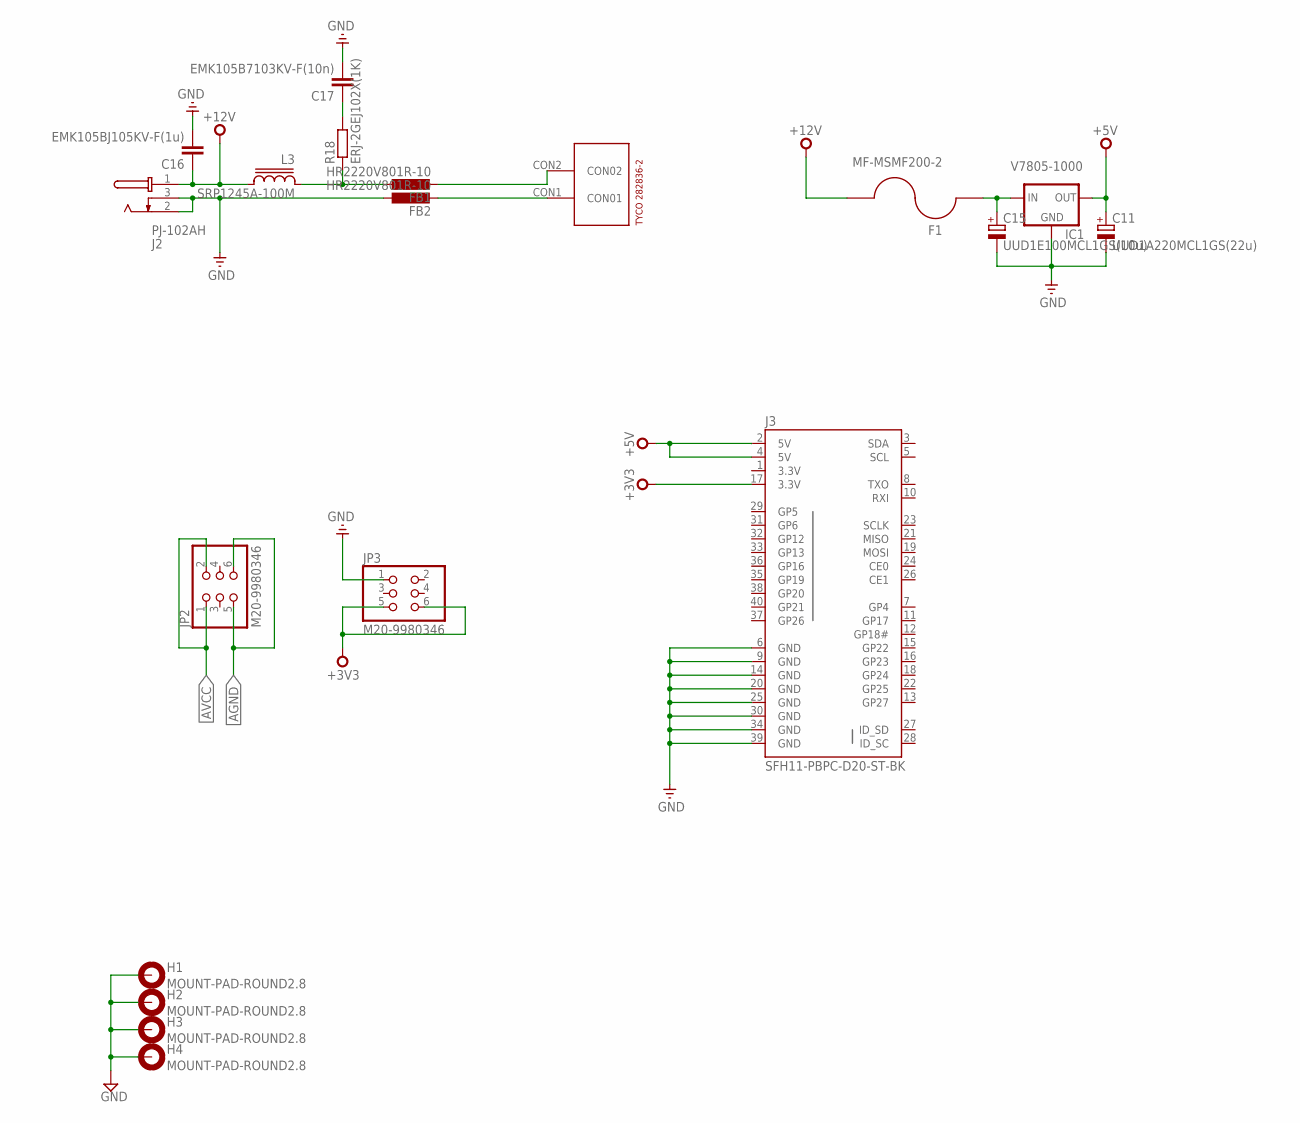
[picture p11: schematic client_board.sch]

Parts:
C11: UUD1A220MCL1GS(22u); 153CLV-0405
C15: UUD1E100MCL1GS(10u); 153CLV-0405
C16: EMK105BJ105KV-F(1u); C0402
C17: EMK105B7103KV-F(10n); C0402
F1: MF-MSMF200-2; 1812
FB1, FB2: HR2220V801R-10; L5650M
H1, H2, H3, H4: MOUNT-PAD-ROUND2.8; 2,8-PAD
IC1: V7805-1000; DIP_3PIN
J2: PJ-102AH; PJ-102XH
J3: SFH11-PBPC-D20-ST-BK; 2X20-SHROUDED
JP2, JP3: M20-9980346; 2X03
L3: SRP1245A-100M; SRP1250A
R18: ERJ-2GEJ102X(1K); R0402
U$1: 282836-2

Connections:
3.3V: J3.1 (3.3V)
+3V3: J3.17 (3.3V), JP3.5, JP3.6
+5V: C11.+, IC1.OUT, J3.2 (5V), J3.4 (5V)
+12V: C16.1, F1.1, J2.1 (T), L3.2
AGND: FB2.2, JP2.5, JP2.6, U$1.CON1 (CON01)
AVCC: FB1.2, JP2.1, JP2.2, U$1.CON2 (CON02)
GND: C11.-, C15.-, C16.2, C17.2, FB2.1, H1.B2,8, H2.B2,8, H3.B2,8, H4.B2,8, IC1.GND, J2.2 (S), J2.3 (SS), J3.6 (GND), J3.9 (GND), J3.14 (GND), J3.20 (GND), J3.25 (GND), J3.30 (GND), J3.34 (GND), J3.39 (GND), JP3.1
unnamed: C15.+, F1.2, IC1.IN
unnamed: FB1.1, L3.1, R18.1
unnamed: C17.1, R18.2

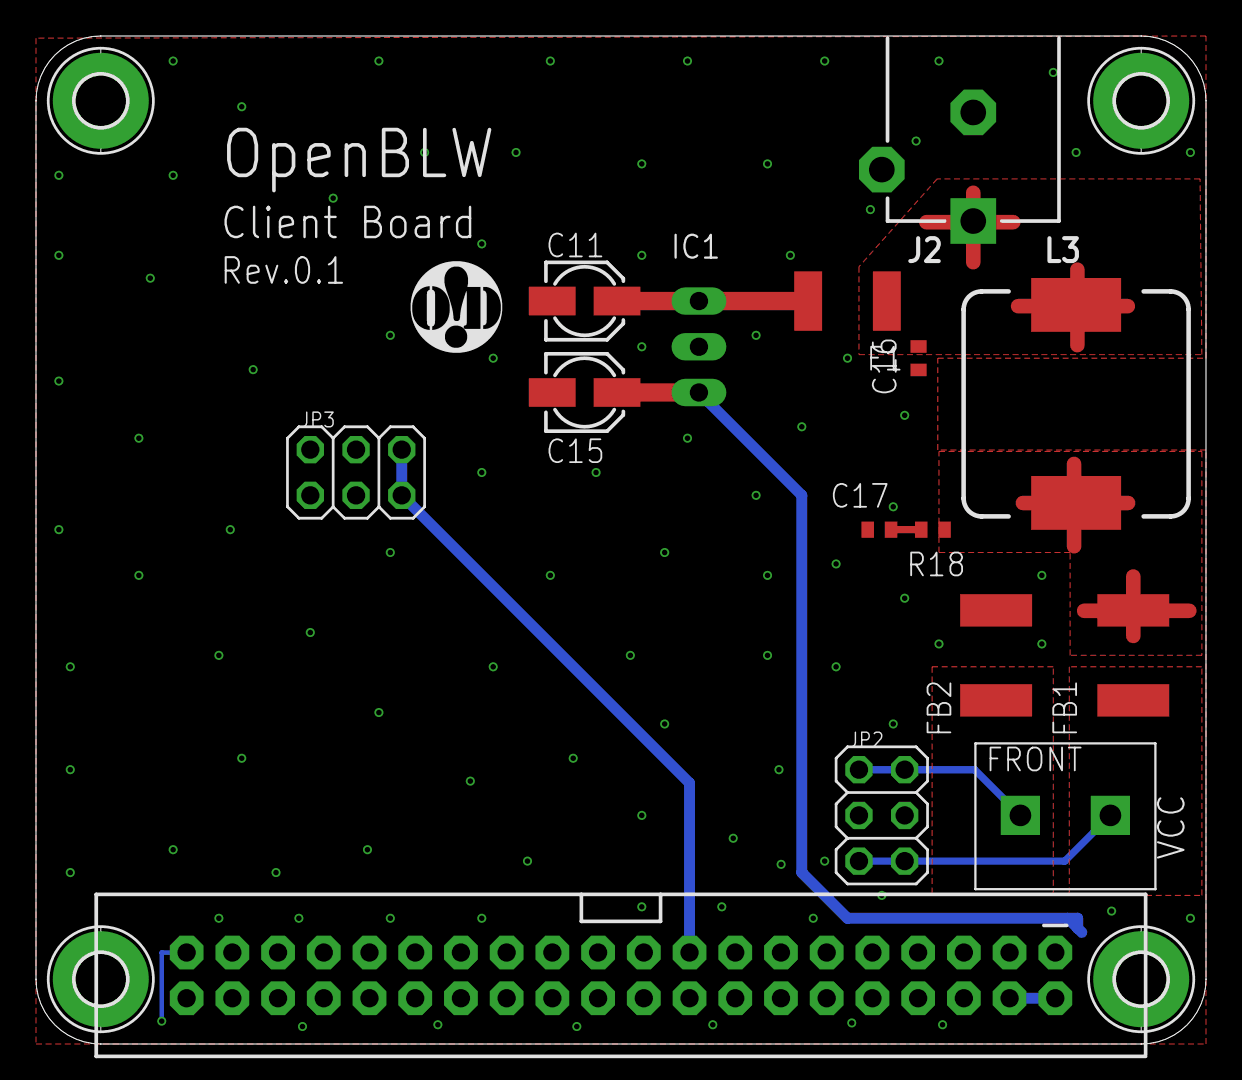
[picture p12: board client_board.brd from above]

Board: 4 copper layers, 65.0 x 56.0 mm, 21 parts (0 on the bottom side), 9 nets.

Other parts of the board:
LOGO1: OHMYDIGIFAB_LOGO
U$2: TENDA_P200
