ohmydigifab/OpenBLW/(commit log)

2015-08-08 improved arm
    [ROVProp.scad, arm.scad, assembly.scad, dxf1.scad]
2015-08-20 resolution tuning
    [assembly.scad, dxf1.scad, params.scad]
2015-08-21 round corner
    [arm.scad, prop_shroud_flange.scad]
2015-08-22 number of bolt has been changed
    [arm.scad, assembly.scad, base_plate.scad, oring_holder.scad, prop_shroud.scad, prop_shroud_flange.scad]
2015-08-22 tuning dxf file
    [ROVProp.scad, arm.scad, assembly.scad, base_plate.scad, dxf_2dot5mm_1.scad, dxf_2dot5mm_2.scad, dxf_3mm_1.scad, dxf_3mm_2.scad]
2015-08-24 shorten prop_shroud
    [assembly.scad, bolt_nut_spacer.scad, flow_cylinder.scad, prop_shroud.scad, prop_shroud_flange.scad]
2015-08-27 tiny modification
    [ROVProp.scad, arm.scad, base_plate.scad, prop_nose.scad, prop_shroud_flange.scad]
2015-08-31 compatibility of 150mm and 100mm
    [arm.scad, assembly.scad, base_plate.scad, params.scad, prop_shroud_flange.scad]
2015-09-08 raspi A+ version
    [LAN_connector.scad, ROVProp.scad, ROVPropAdapter.scad, arm.scad, arm_upper.scad, assembly.scad, base_plate.scad, base_plate_assembly.scad]
2015-09-24 Raspi A+ prototype
    [ROVPropAdapter.scad, arm.scad, arm_upper.scad, assembly.scad, base_plate_bottom.scad, base_plate_middle.scad, base_plate_upper.scad, oring_holder.scad]
2015-09-24 parametalize PROP_SHROUD_DIA
    [arm.scad, arm_upper.scad, assembly.scad, base_plate_bottom.scad, base_plate_upper.scad, oring_holder.scad, params.scad, prop_shroud.scad]
2015-09-26 baseplate improved num of prop blades got 6
    [ROVProp.scad, ROVPropAdapter.scad, assembly.scad, base_plate_bottom.scad, base_plate_middle.scad, base_plate_upper.scad, oring_holder.scad]
2015-10-05 use minkowski
    [arm.scad, arm_upper.scad, base_plate_bottom.scad, base_plate_middle.scad, base_plate_upper.scad, params.scad, prop_shroud_flange.scad]
2015-10-09 camera holder
    [camera_holder.scad]
2015-10-09 design change of upper arm
    [arm.scad, arm_upper.scad, prop_shroud_flange.scad]
2015-10-09 image & parametric
    [ROVProp.scad, assembly.scad]
2016-01-15 small modifications
    [ROVProp.scad, ROVPropAdapter.scad, assembly.scad, base_plate_bottom.scad, base_plate_middle.scad, base_plate_upper.scad, camera_holder.scad, prop_shroud_flange.scad]
2016-01-15 doble side
    [base_plate_bottom.scad, base_plate_middle.scad, base_plate_upper.scad]
2016-01-15 yaw lock
2016-01-24 eagle cad files
    [RPI-CMIO-V1_2-PUBLIC-BOM.xlsx, main_controller_board.brd, main_controller_board.sch]
2016-01-25 add dc-dc
    [main_controller_board.brd, main_controller_board.sch]
2016-01-30 porovisional wiring
    [main_controller_board.brd, main_controller_board.sch]
2016-02-02 before export gerber
    [main_controller_board.brd, main_controller_board.sch]
2016-02-02 before order 0
    [main_controller_board.brd, manufacturing_directions.xls]
2016-02-03 0.5mm clearance
    [main_controller_board.brd, main_controller_board.sch]
2016-02-12 client board
    [client_board.brd, client_board.sch, driver_board.brd, interface_board-BOM.xls, interface_board.brd, interface_board.sch, parts_list.xls]
2016-02-16 before order pcbs
    [Bom.csv, client_board-BOM.xls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]
2016-02-16 parts miss
    [BOM.csv, Bom.csv, client_board-BOM.xls, client_board.brd, client_board.sch, interface_board-BOM.xls, interface_board.brd, interface_board.sch]
