ohmydigifab/OpenBLW/(notices)

Notices in the files:
parts and their libraries:
dports: Copyright (C) 2008, Bob Starr
supply0: Copyright (C) 2007, Bob Starr
SparkFun-Boards: Licensing: Creative Commons ShareAlike 4.0 International - https://creativecommons.org/licenses/by-sa/4.0
con-dc-power: Copyright (C) 2015, Bob Starr
